palzhj/u4FCPv2/template/u4FCPv2/KUP/sitcp/Projects/README.md

# Project folder

This is temporary folder for project. When working on a project, temporary folders are automatically created to store intermediate and temporary files generated during the various stages of the design process.

**This folder can be cleared when necessary.**
