palzhj/u4FCPv2/template/u4FCPv2/KUP/sitcpxg-fmc1_dp0/scripts/README.md

# Script folder

This is a TCL script folder for vivado.

In Vivado, TCL (Tool Command Language) scripts are used to automate various tasks, perform design operations, and customize the design flow. These scripts are written in the TCL programming language and can be executed within the Vivado environment.
