palzhj/u4FCPv2/template/u4FCPv2/POWER/README.md

# UCD Power Limit

## FMC 12V0

| Spec. Limit | UCD Warning Limit | UCD Software Control Automatic Shutdown Limit | Hardware Shutdown Limit |
| --- | --- | --- | --- |
| 1A  | 2A  | 3A  | 4A  |

## FMC 3V3

| Spec. Limit | UCD Warning Limit | UCD Software Control Automatic Shutdown Limit | Hardware Shutdown Limit |
| --- | --- | --- | --- |
| 3A  | 3A  | 3.5A| 4A  |

## FMC VADJ

| Spec. Limit | UCD Warning Limit | UCD Software Control Automatic Shutdown Limit | Hardware Shutdown Limit |
| --- | --- | --- | --- |
| 4A  | 4A  | 5A  | 6A by DC/DC max output |

## RTM 12V0

| Spec. Limit | UCD Warning Limit | UCD Software Control Automatic Shutdown Limit | Hardware Shutdown Limit |
| --- | --- | --- | --- |
| 3A  | 3.5A| 4.5A| 10.91A |
