palzhj/u4FCPv2/outline/uRTM_dimension.pdf

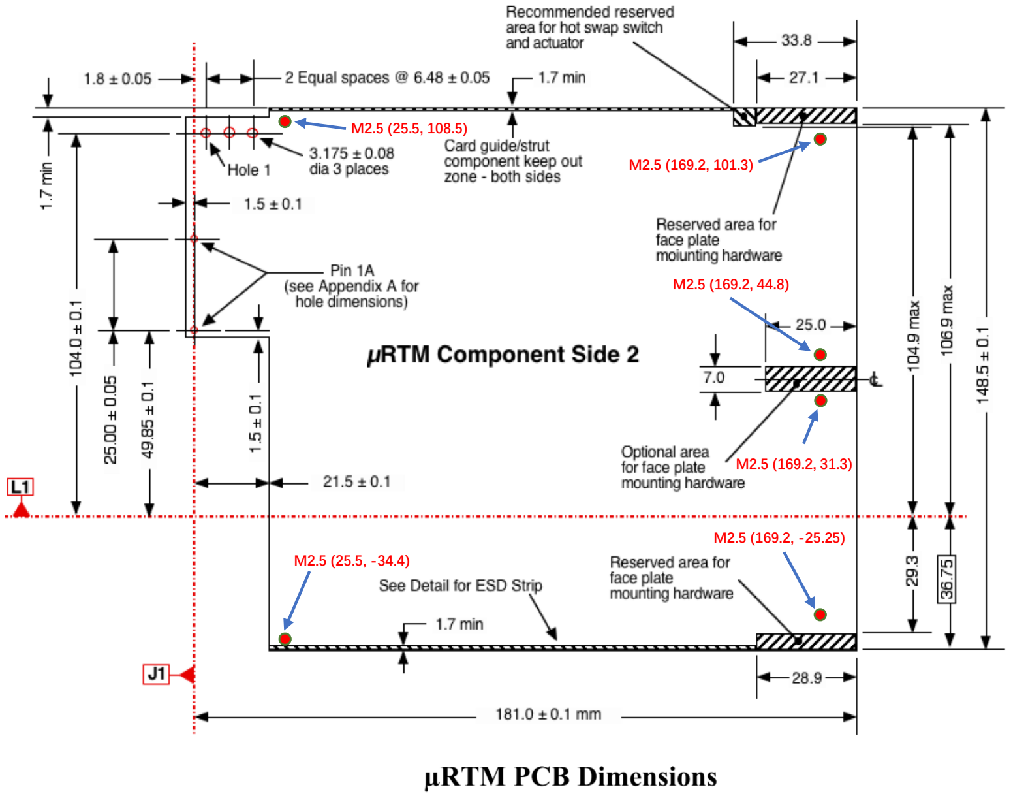
[picture p19: page 1]

M2.5 (169.2, 101.3)

M2.5 (169.2, -25.25)

M2.5 (169.2, 31.3)

M2.5 (169.2, 44.8)

M2.5 (25.5, 108.5)

M2.5 (25.5, -34.4)
