palzhj/u4FCPv2/template/u4FCPv2/KUP/sitcp/sources/wishbone/wb_reg/reg_table.xlsx

block name | reg_table
byte size | 256
bus width | 8
protocol | wishbone
name | offset addres | size | type | name | assignment | type | initial value | reference | labels | comment
syn_info |  |  |  | hour | 8 | rof | default: 0x0 |  |  | Synthesis date - hour, BCD (00-23)
 |  |  |  | date | 8 | rof | default: 0x0 |  |  | Synthesis date - day of month, BCD (01-31)
 |  |  |  | month | 8 | rof | default: 0x0 |  |  | Synthesis date - month, BCD (01-12)
 |  |  |  | year | 8 | rof | default: 0x0 |  |  | Synthesis date - two-digit year, BCD (00-99); century implied
syn_ver |  |  |  |  | 8 | rof | default: 0x0 |  |  | Firmware version (auto update at synthesis)
sys_rst |  |  |  | usr_rst | 1 | w1trg | default: 0x0 |  |  | Write 1 to generate a reset pulse for the user logic; write 0 has no effect
 |  |  |  | ddr_rst | 1 | w1trg | default: 0x0 |  |  | Write 1 to generate a reset pulse for the DDR; write 0 has no effect
mod_rst |  |  |  | mod_rst | 1 | w1trg | default: 0x0 |  |  | Write 1 to generate a reset pulse for the front-end modules; write 0 has no effect
 |  |  |  | qsfp_rst | 1 | w1trg | default: 0x0 |  |  | Write 1 to generate a reset pulse for the QSFP; write 0 has no effect
sys_sta |  |  |  | clk_lock | 1 | ro | default: 0x0 |  |  | 0 = MMCM not locked; 1 = MMCM locked
sys_sta_lch |  |  |  | clk_lock | 1 | rotrg | default: 0x0 |  |  | Latched copy of sys_sta.clk_lock. Sticky: cleared by reading this register
mod_sta |  |  |  | temp_alm | 1 | ro | default: 0x0 |  |  | 0 = Normal; 1 = Over-temperature alarm
 |  |  |  | lv_alm | 1 | ro | default: 0x0 |  |  | 0 = Normal; 1 = Low-voltage over-current alarm
 |  |  |  | hv_alm | 1 | ro | default: 0x0 |  |  | 0 = Normal; 1 = High-voltage over-current alarm
 |  |  |  | qsfp_alm | 1 | ro | default: 0x0 |  |  | 0 = Normal; 1 = QSFP28 alarm (module fault or critical host status)
 |  |  |  | qsfp_prs | 1 | ro | default: 0x0 |  |  | 0 = QSFP module absent; 1 = QSFP module present
mod_sta_lch |  |  |  | temp_alm | 1 | rotrg | default: 0x0 |  |  | Latched copy of mod_sta.temp_alm. Sticky: cleared by reading this register
 |  |  |  | lv_alm | 1 | rotrg | default: 0x0 |  |  | Latched copy of mod_sta.lv_alm. Sticky: cleared by reading this register
 |  |  |  | hv_alm | 1 | rotrg | default: 0x0 |  |  | Latched copy of mod_sta.hv_alm. Sticky: cleared by reading this register
 |  |  |  | qsfp_alm | 1 | rotrg | default: 0x0 |  |  | Latched copy of mod_sta.qsfp_alm. Sticky: cleared by reading this register
 |  |  |  | qsfp_prs | 1 | rotrg | default: 0x0 |  |  | Latched copy of mod_sta.qsfp_prs. Sticky: cleared by reading this register
clk |  |  |  | ext_en | 1 | rw | default: 0x0 |  |  | 0 = Use on-board/local clock; 1 = Use external clock from AMC
lv |  |  |  | enable | 1 | rw | default: 0x0 |  |  | 0 = Module power OFF; 1 = Module power ON
 |  |  |  | ot_auto_off | 1 | rw | default: 0x0 |  |  | 0 = Normal; 1 = Auto power OFF on over-temperature
hv |  |  |  | stop | 1 | rw | default: 0x1 |  |  | 0 = High voltage ON; 1 = High-voltage emergency shutdown (safe default: 1)
 |  |  |  | oc_auto_off | 1 | rw | default: 0x0 |  |  | 0 = Normal; 1 = Auto power OFF on over-current
qsfp |  |  |  | lpmode | 1 | rw | default: 0x0 |  |  | 0 = Normal (Full-Power) mode; 1 = Low-Power mode
