palzhj/u4FCPv2/template/u4FCPv2/KUP/sitcpxg-fmc1_dp0/sources/wishbone/wb_reg/reg_table.xlsx

block name | reg_table
byte size | 256
name | offset addres | size | type | name | assignment | type | initial value | reference | labels | comment
syn_info |  |  |  | hour | 8 | rof | default: 0x0 |  |  | Synthesis date: Hour, binary-coded decimal expression
 |  |  |  | date | 8 | rof | default: 0x0 |  |  | Synthesis date: Date
 |  |  |  | month | 8 | rof | default: 0x0 |  |  | Synthesis date: Month
 |  |  |  | year | 8 | rof | default: 0x0 |  |  | Synthesis date: Last two figures of A.D.
syn_ver |  |  |  |  | 8 | rof | default: 0x0 |  |  | Firmware Version
fpga_dna |  |  |  |  | 64 | ro |  |  |  | FPGA DNA ID
tcp_mode |  |  |  |  | 2 | rw | default: 0x0 |  |  | TCP mode: 2’b01 - Loopback mode, 2’b10 - Test mode, 2’b00 – Normal mode
tcp_test_tx_rate |  |  |  |  | 8 | rw | default: 0x1 |  |  | Transmission data rate in units of 100 Mbps for TCP test mode
tcp_test_num_of_data |  |  |  |  | 64 | rw | default: 0x4000 |  |  | Number of bytes to be transmitted for TCP test mode
tcp_test_data_gen |  |  |  |  | 1 | rw | default: 0x0 |  |  | Data transmission enable for TCP test mode
tcp_test_word_len |  |  |  |  | 3 | rw | default: 0x7 |  |  | Word length of test data for one clock cycle for TCP test mode
tcp_test_select_seq |  |  |  |  | 1 | rw | default: 0x0 |  |  | Use the sequence pattern as defined below for TCP test mode
tcp_test_seq_pattern |  |  |  |  | 32 | rw | default: 0x60808040 |  |  | Sequence pattern, each 4-bit define the number of bytes for one clock cycle
tcp_test_blk_size |  |  |  |  | 24 | rw | default: 0x400 |  |  | Transmission block size in bytes for TCP test mode
tcp_test_ins_error |  |  |  |  | 1 | w1trg | default: 0x0 |  |  | Data error insertion for TCP test mode
