palzhj/u4FCPv2/outline/URTM_V2_3D_bare_pcb.stp

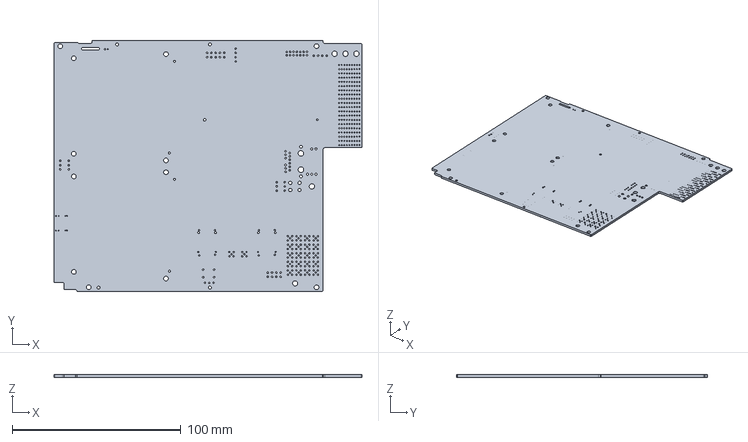
[picture p20: CAD file, 2025-03-28]
outline/URTM_V2_3D_bare_pcb.stp
182.5 x 148.5 x 1.58 mm
