palzhj/u4FCPv2/outline/U4FCP_V2_bare_pcb.stp

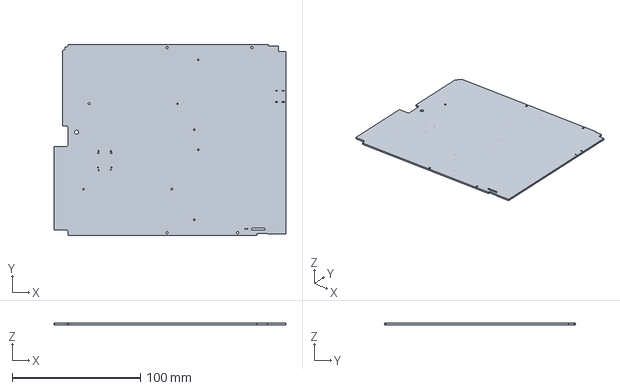
[picture p21: CAD file, 2025-03-26]
outline/U4FCP_V2_bare_pcb.stp
180.6 x 148.5 x 1.43 mm
