palzhj/u4FCPv2/template/uRTMv2/K7/URTM_V2_3r.pdf

# RTM

# ReDri

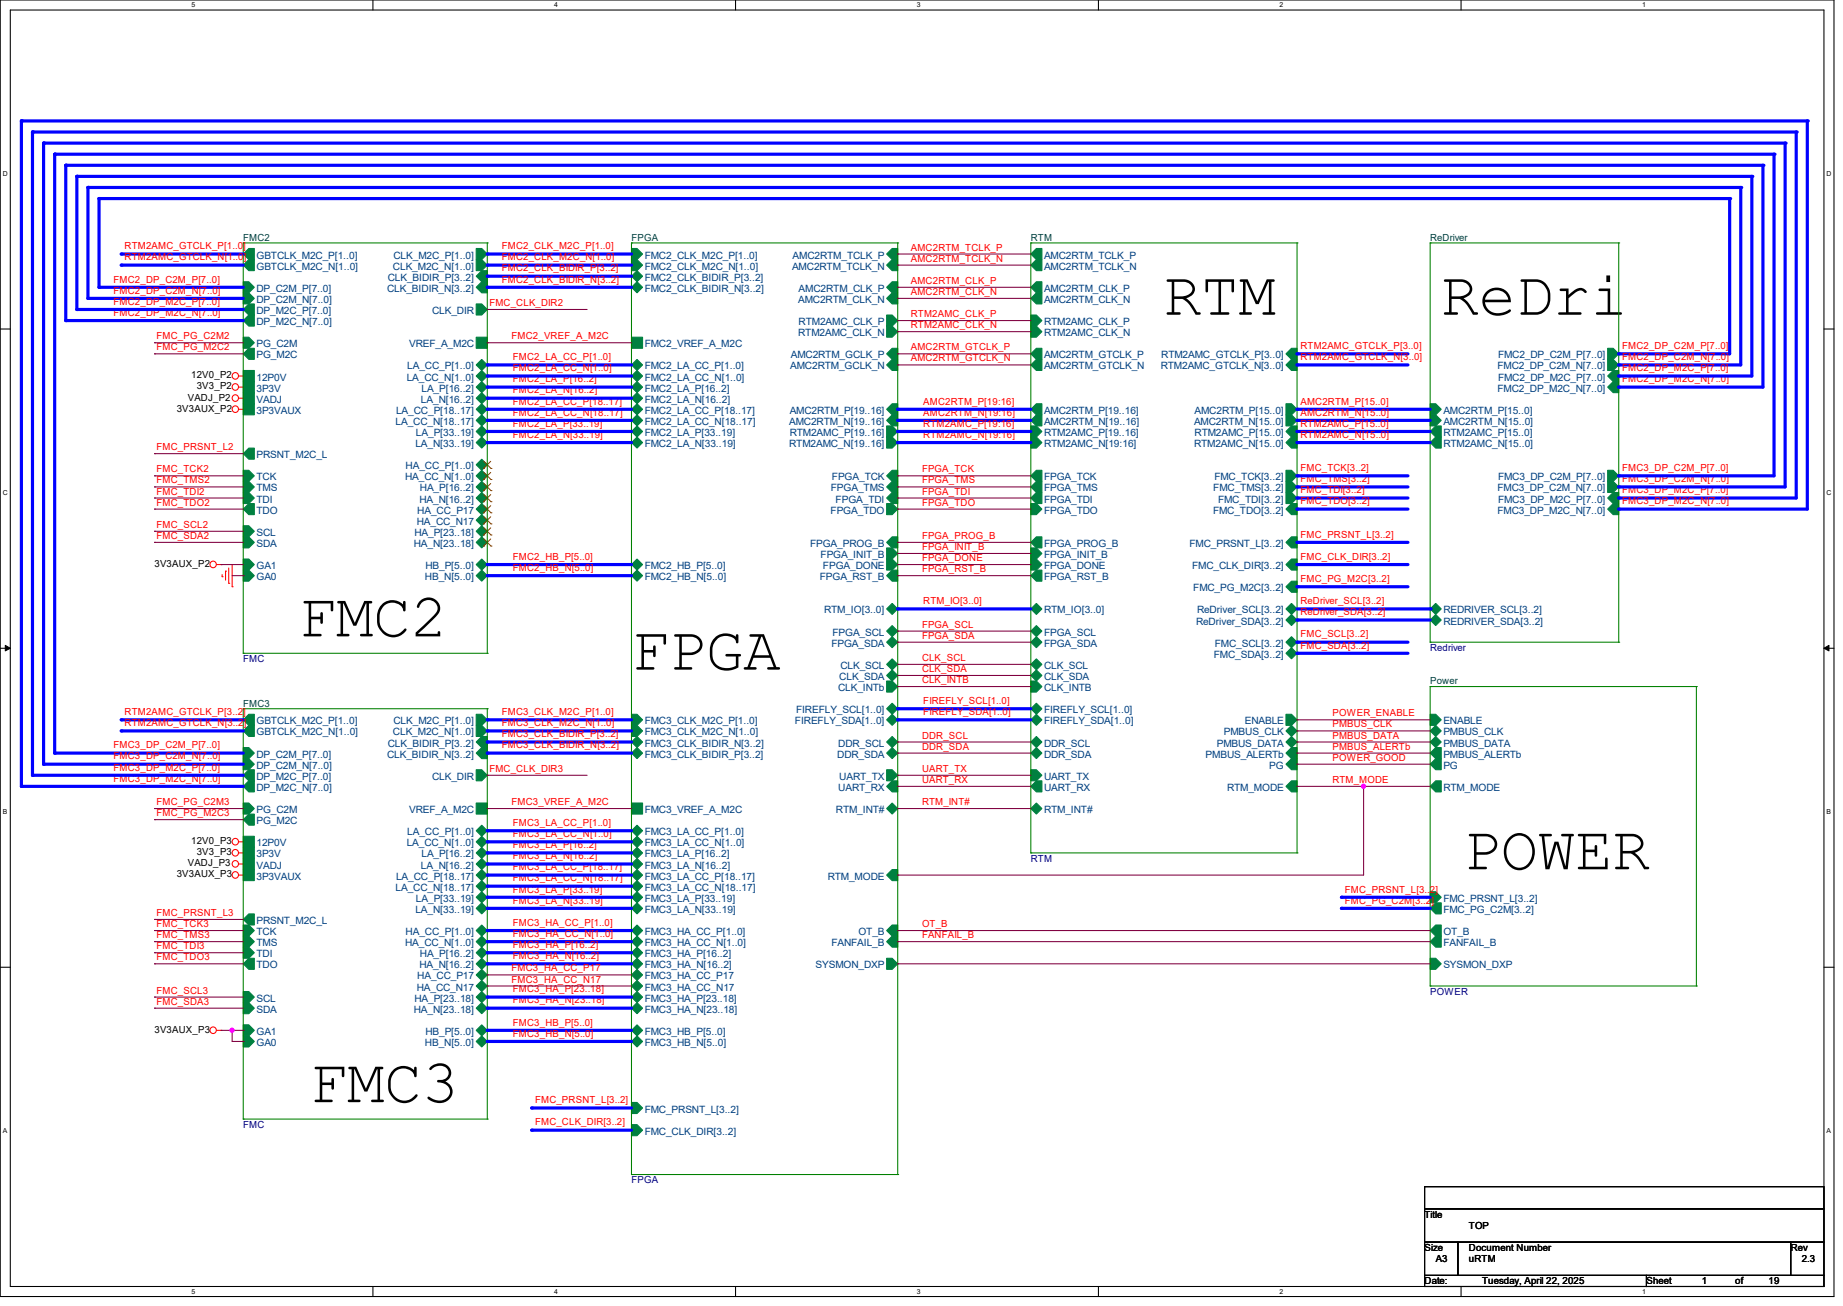
[picture p22: page 1]
FPGA; FMC3; FMC2; POWER; 3V3AUX_P3; 3V3AUX_P3 VADJ_P3; 3V3AUX_P2; 3V3AUX_P2 VADJ_P2; Title Size; Document Number; Rev Date:; Sheet; of uRTM; 2.3 TOP; Tuesday, April 22, 2025; 19 Title Size; FMC3_LA_CC_N[18..17] FMC3_LA_N[33..19] FMC3_LA_P[33..19] FMC3_LA_CC_P[18..17]; FPGA_SCL FPGA_SDA; FMC3_VREF_A_M2C; FMC3_LA_CC_N[1..0] FMC3_LA_CC_P[1..0] FMC3_LA_P[16..2] FMC3_LA_N[16..2]; FPGA_DONE; FPGA_PROG_B; FPGA_TDI FPGA_INIT_B; FPGA_TMS; FPGA_TCK; FPGA_RST_B; FPGA_TDO; SYSMON_DXP; CLK_SCL CLK_SDA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

# FMC2_CLK_OUT_P2 FMC2_CLK_OUT_N2 FMC3_CLK_OUT_P2 FMC3_CLK_OUT_N2 FPGA_CLK_SW_P

# IN2 15 SCLK 16 A1/SDO 17 SDA/SDIO 18

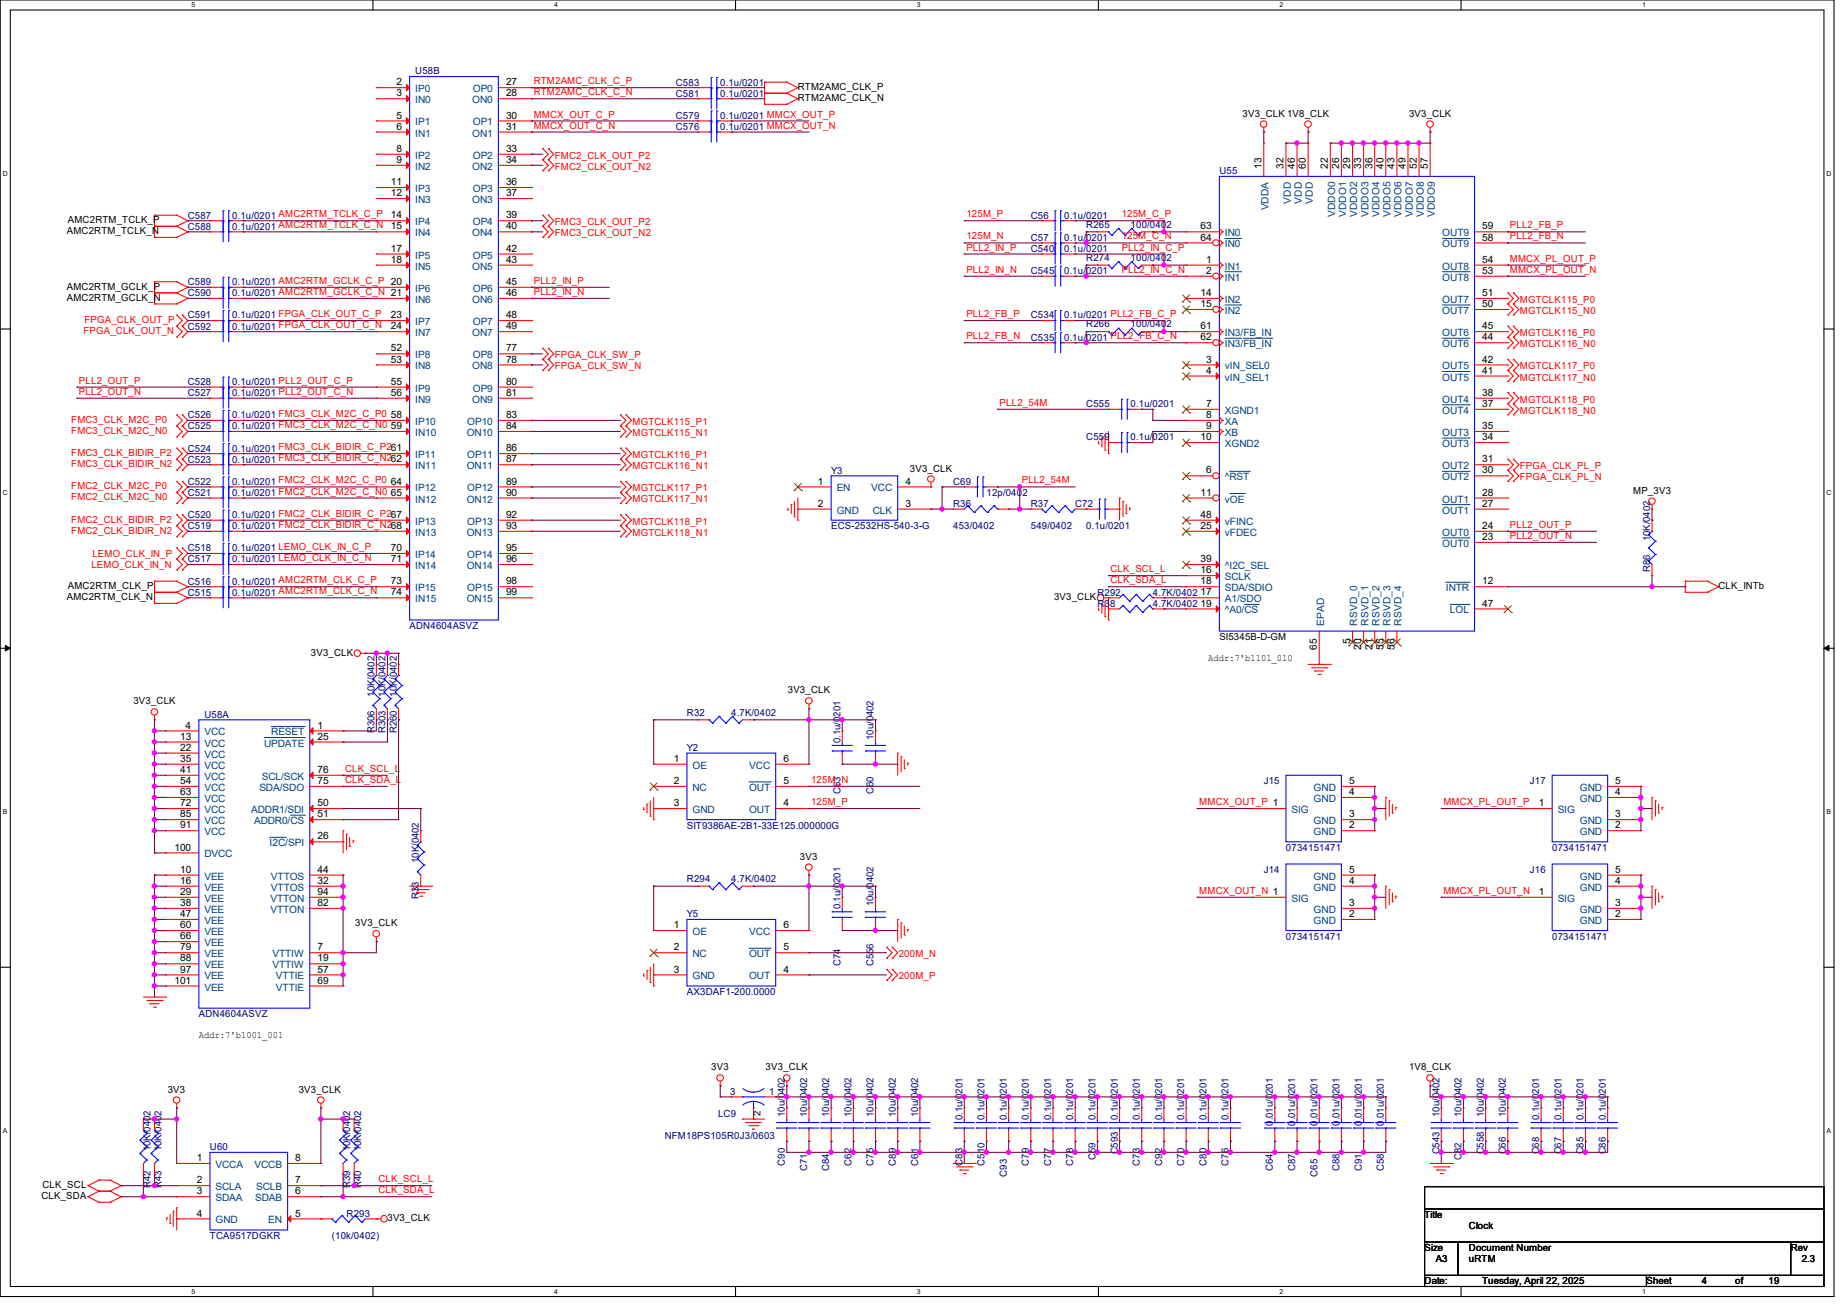
[picture p23: page 2]

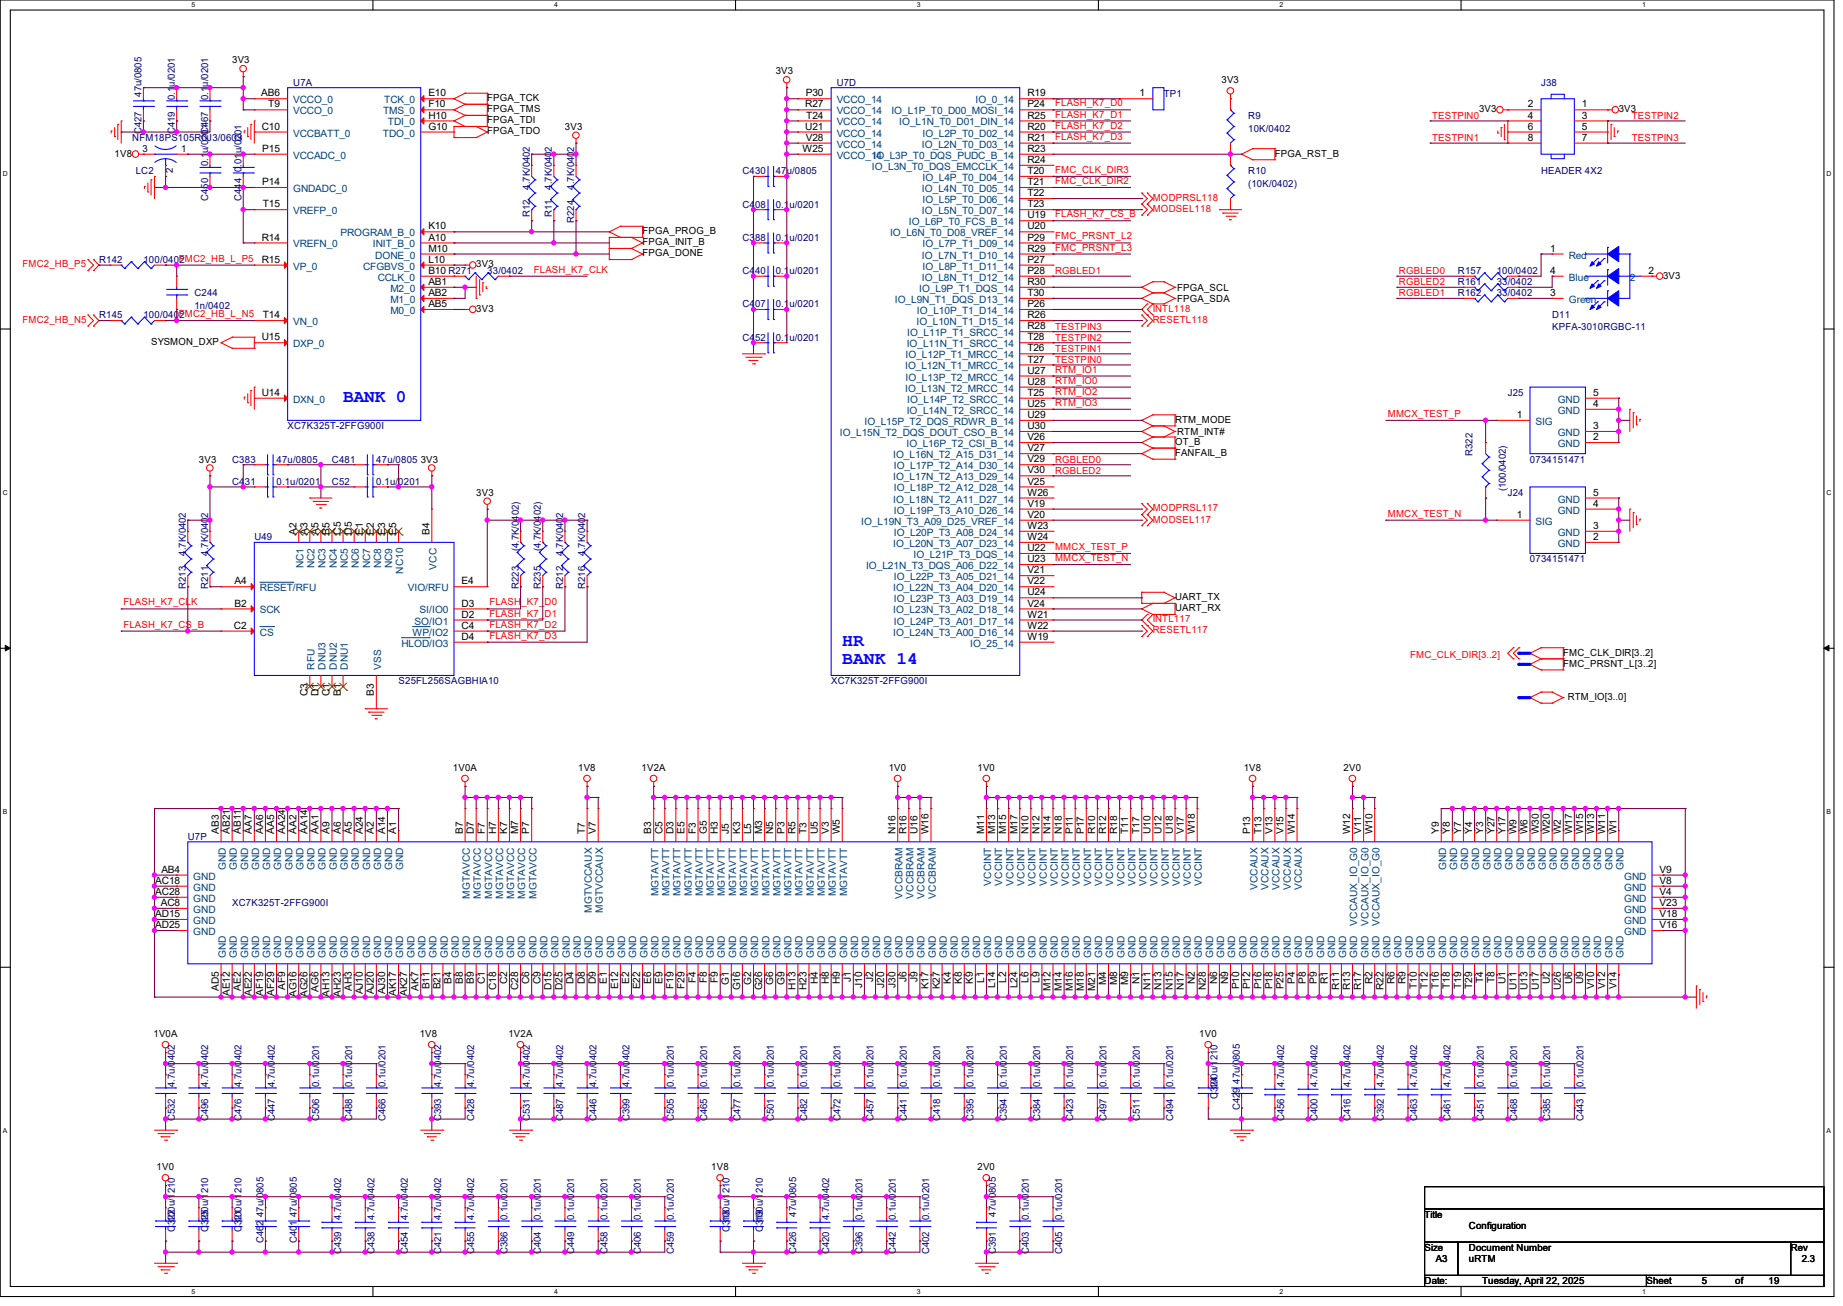
[picture p24: page 3]

# 1V35 VTTVREF

C379 | 0.1u/0201 C320 | 100u/1210 C²³⁹⁰.1u/0201 | R199

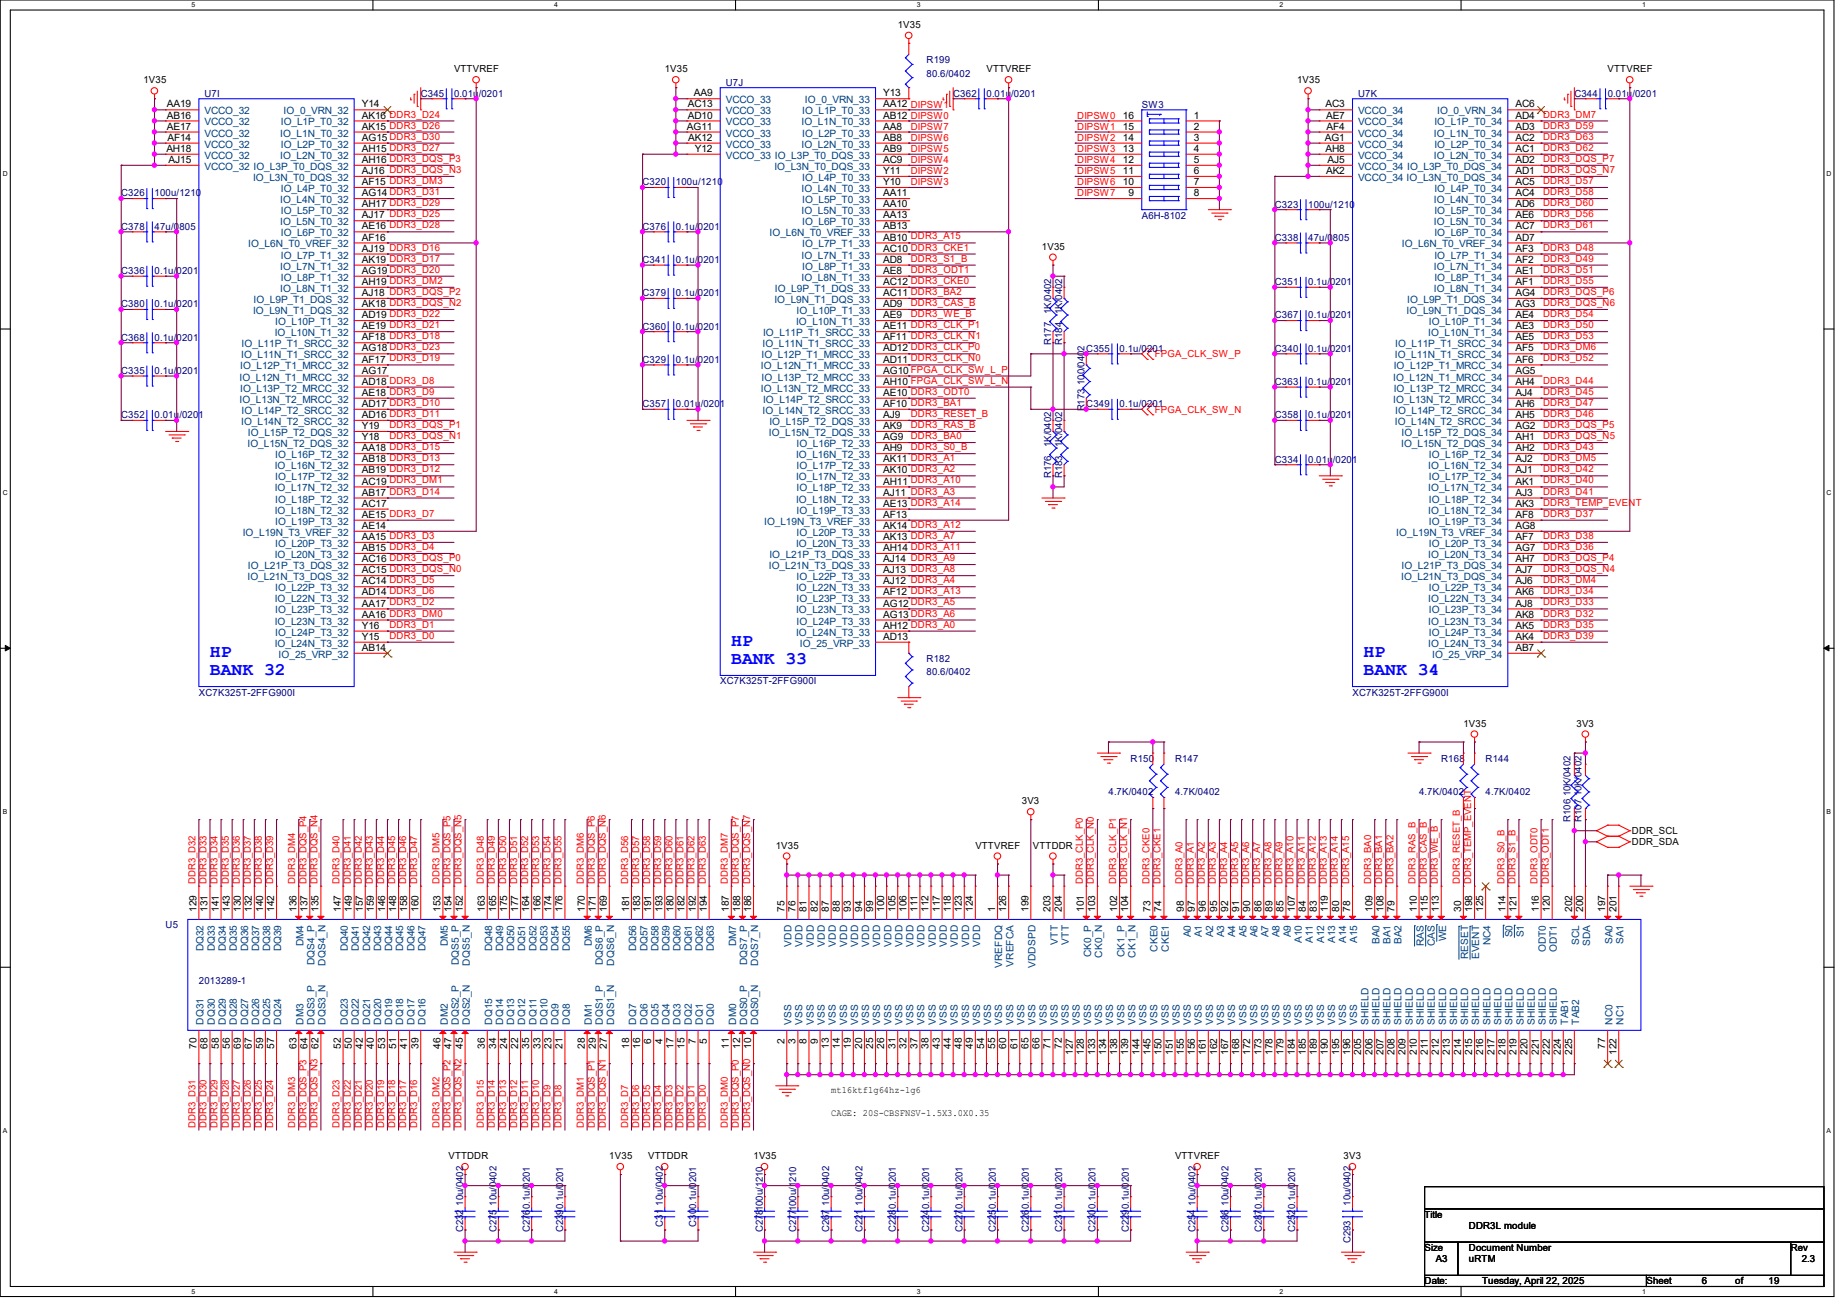
[picture p25: page 4]

6 DQ6 16 DQ7 18 DQ8 21 DQ9 23 DQ10 33 DQ11 35 DQ12 22 DQ13 24 DQ14 34 DQ15 36 DQ16 39 DQ17 41 DQ18 51 DQ19 53 DQ20 40 DQ21 42 DQ22 50 DQ23 52 DQ24 57 DQ25 59 DQ26 67 DQ27 69 DQ28 56 DQ29 58 DQ30 68 DQ31 70 DQ32 129 DQ33 131 DQ34 141 DQ35 143 DQ36 130 DQ37 132 DQ38 140 DQ39 142 DQ40 147 DQ41 149 DQ42 157 DQ43 159 DQ44 146 DQ45 148 DQ46 158 DQ47 160 DQ48 163 DQ49 165 DQ50 175 DQ51 177 DQ52 164 DQ53 166 DQ54 174 DQ55 176 DQ56 181 DQ57 183 DQ58 191 DQ59 193 DQ60 180 DQ61 182 DQ62 192 DQ63 194 DQS0_N 10 DQS0_P 12 DQS1_N 27 DQS1_P 29 DQS2_N 45 DQS2_P 47 DQS3_N 62 DQS3_P 64 DQS4_N 135 DQS4_P 137 DQS5_N 152 DQS5_P 154 DQS6_N 169 DQS6_P 171 DQS7_N 186 DQS7_P 188 NC0 77 A15 78 A14 80 NC1 122 NC4 125 ODT0 116 ODT1 120 SA0 197 SA1 201 SCL 202 SDA 200 VDD 75 VDD 76 VDD 81 VDD 82 VDD 87 VDD 88 VDD 93 VDD 94 VDD 99 VDD 100 VDD 105 VDD 106 VDD 111 VDD 112 VDD 117 VDD 118 VDD 123 VDD 124 VDDSPD 199 VREFCA 126 VREFDQ

9 VSS 13 VSS 14 VSS 19 VSS 20 VSS 25 VSS 26 VSS 31 VSS 32 VSS 37 VSS 38 VSS 43 VSS 44 VSS 48 VSS 49 VSS 54 VSS 55 VSS 60 VSS 61 VSS 65 VSS 66 VSS 71 VSS 72 VSS 127 VSS 128 VSS 133 VSS 134 VSS 138 VSS 139 VSS 144 VSS 145 VSS 150 VSS 151 VSS 155 VSS 156 VSS 161 VSS 162 VSS 167 VSS 168 VSS 172 VSS 173 VSS 178 VSS 179 VSS 184 VSS 185 VSS 189 VSS 190 VSS 195 VSS 196 SHIELD 205 SHIELD 206 SHIELD 207 SHIELD 208 SHIELD 209 SHIELD 210 SHIELD 211 SHIELD 212 SHIELD 213 SHIELD 214 SHIELD 215 SHIELD 216 SHIELD 217 SHIELD 218 SHIELD 219 SHIELD 220 SHIELD 221 SHIELD 222 TAB1 224 TAB2 225

0734151471 SIG 1 | GND 2 GND 3 GND 4 GND 5 | R²⁸⁷ ¹⁰K/0402
0734151471 SIG 1 | GND 2 GND 3 GND 4 GND 5 R²⁸⁴ ¹⁰K/0402

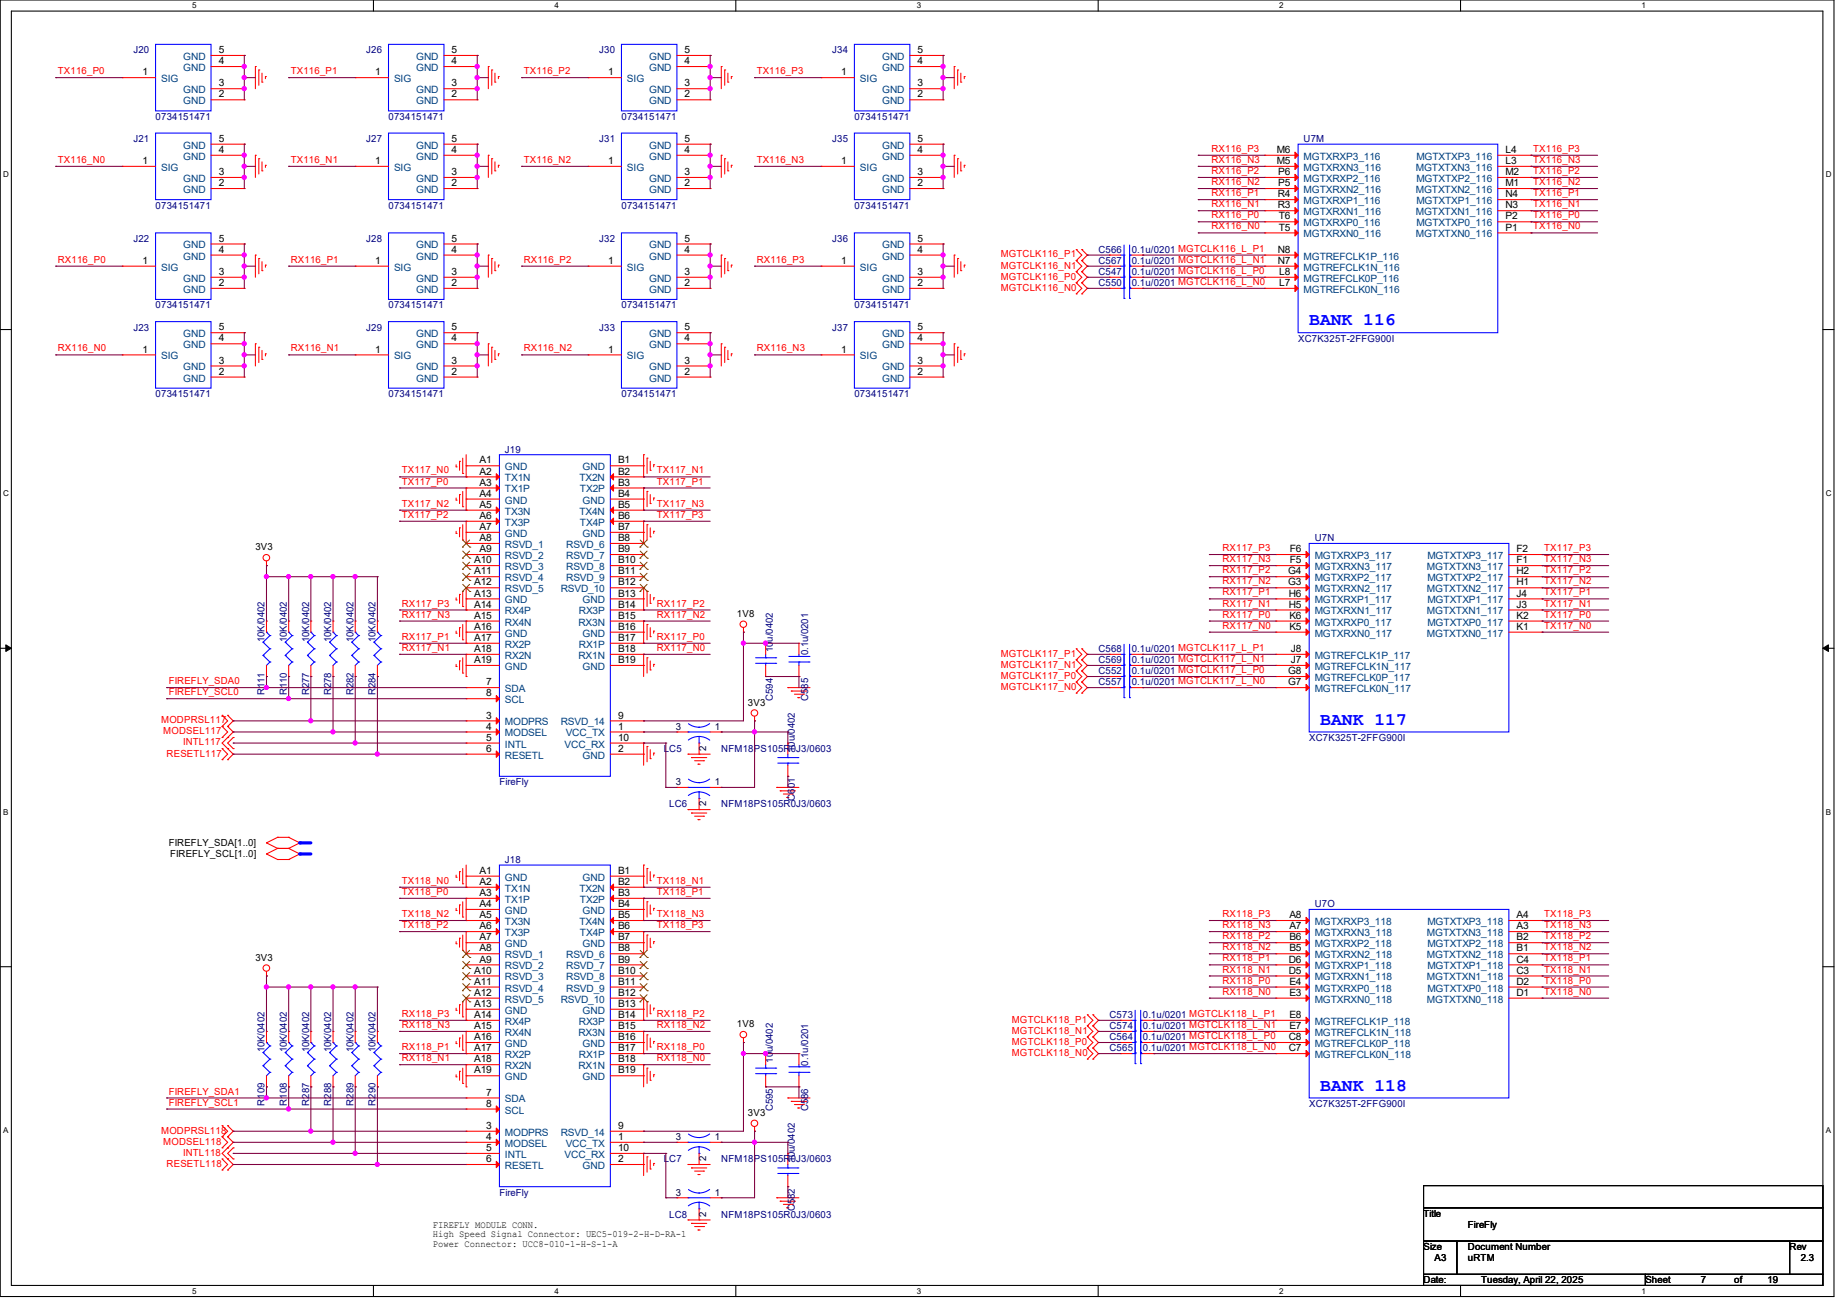
[picture p26: page 5]

High Speed Signal Connector: UEC5-019-2-H-D-RA-1
Power Connector: UCC8-010-1-H-S-1-A

FMC2_LA_P3 FMC2_LA_N3 FMC2_LA_P15 FMC2_LA_N15 FMC2_LA_P12 FMC2_LA_N12 FMC2_LA_P14 FMC2_LA_N14 FMC2_LA_P16 FMC2_LA_N16 FMC2_LA_CC_P1 FMC2_LA_CC_N1 FMC2_LA_P2 FMC2_LA_N2 FMC2_LA_N4 FMC2_LA_P4 FMC2_LA_P6 FMC2_LA_N6 FMC2_LA_P30 FMC2_LA_N30 FMC2_LA_P31 FMC2_LA_N31 FMC2_LA_P28 FMC2_LA_N28 FMC2_LA_CC_P18 FMC2_LA_CC_N18 FMC2_LA_P27 FMC2_LA_N27 FMC2_LA_P25 FMC2_LA_N25 FMC2_LA_P20 FMC2_LA_N20 FMC2_LA_P23 FMC2_LA_N23

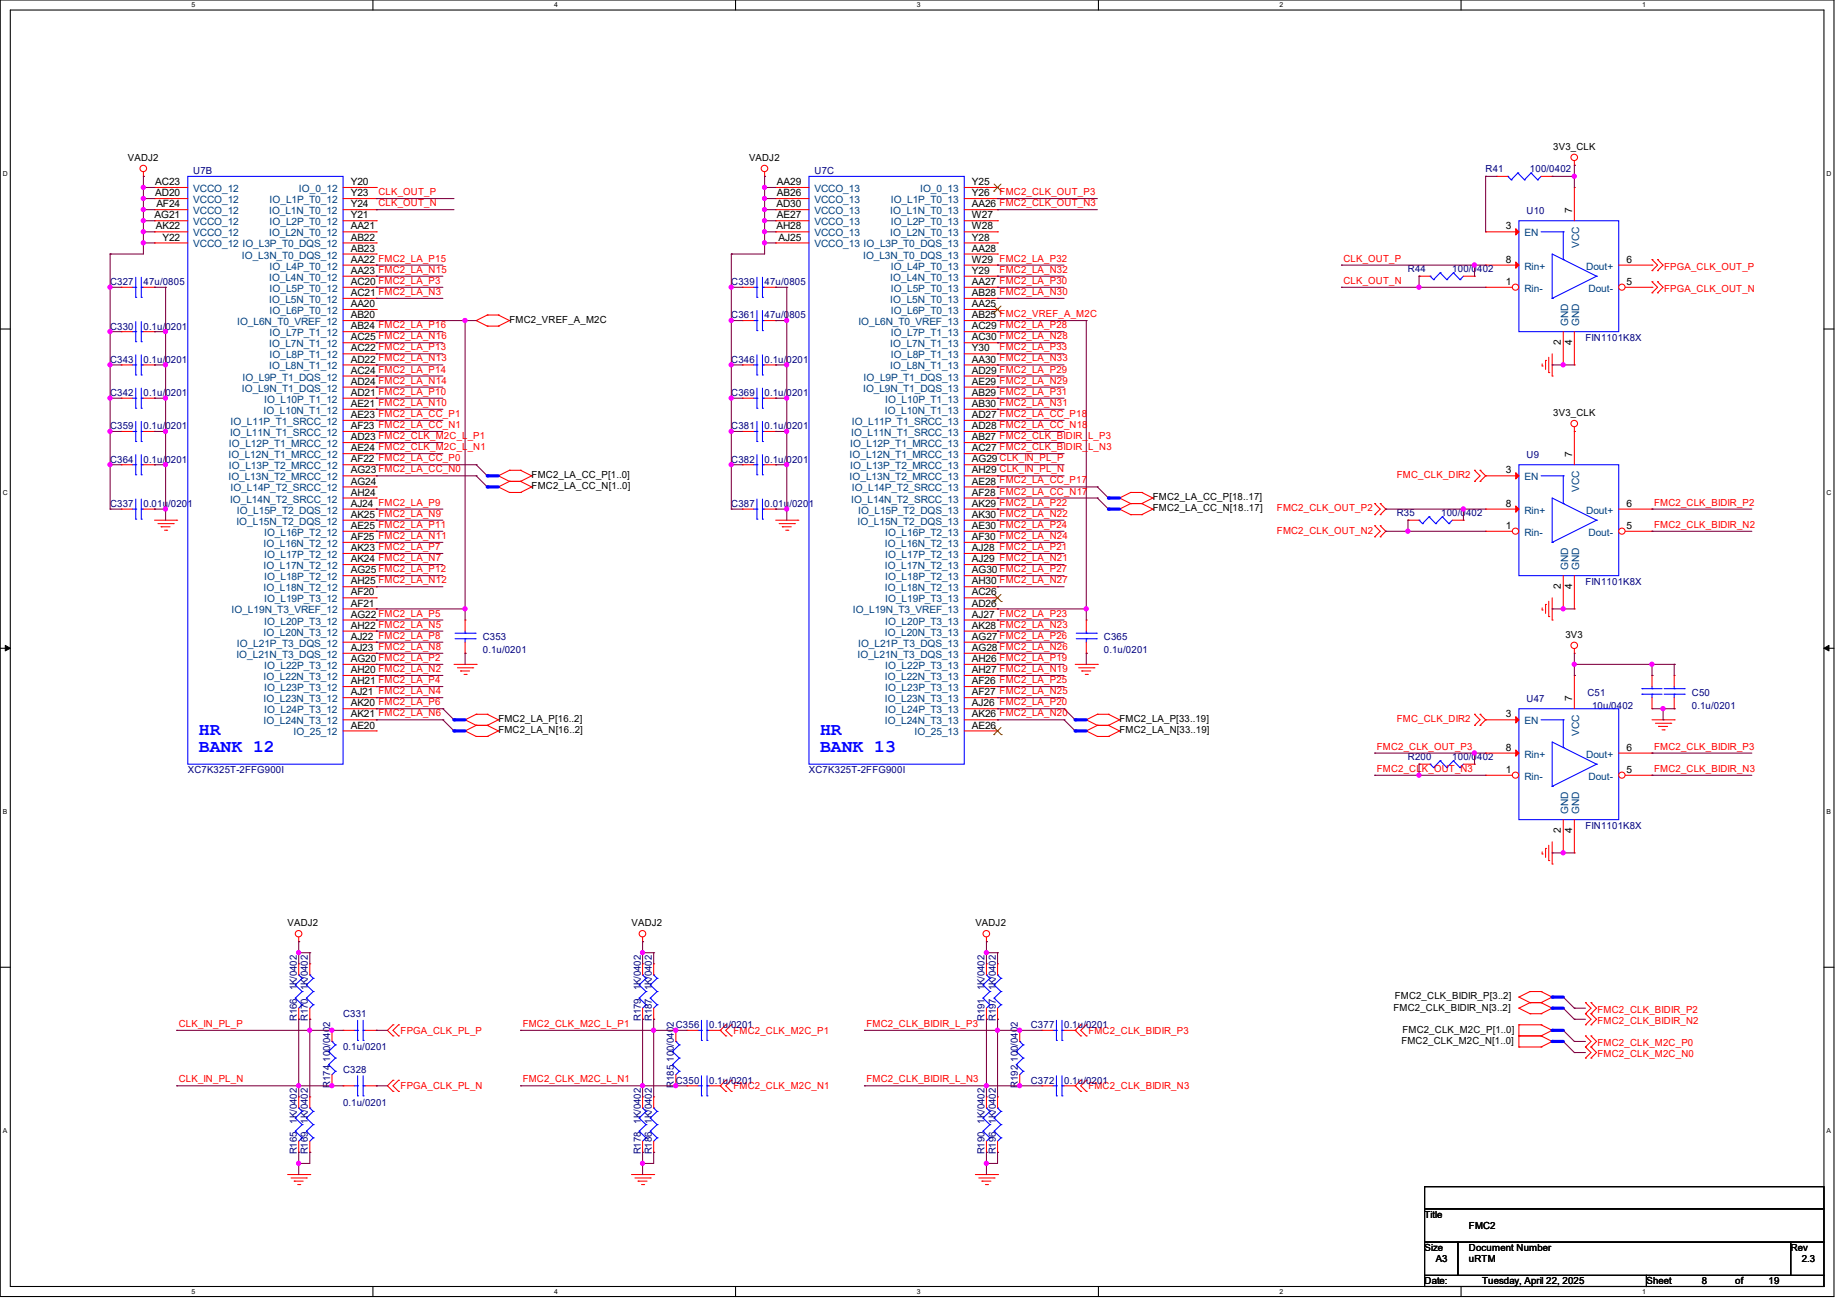
[picture p27: page 6]

FMC3_LA_CC_N1 FMC3_LA_CC_P1 FMC3_LA_N10 FMC3_LA_P10 FMC3_LA_N14 FMC3_LA_P14 FMC3_LA_N13 FMC3_LA_P13 FMC3_LA_N16 FMC3_LA_P16 FMC3_LA_N6 FMC3_LA_P6 FMC3_LA_N5 FMC3_LA_P5 FMC3_LA_N8 FMC3_LA_P8 FMC3_LA_N12 FMC3_LA_P12
FMC3_LA_N11 FMC3_LA_P11 FMC3_LA_N9 FMC3_LA_P9 FMC3_LA_N4 FMC3_LA_P4 FMC3_LA_N3 FMC3_LA_P3 FMC3_LA_N2 FMC3_LA_P2

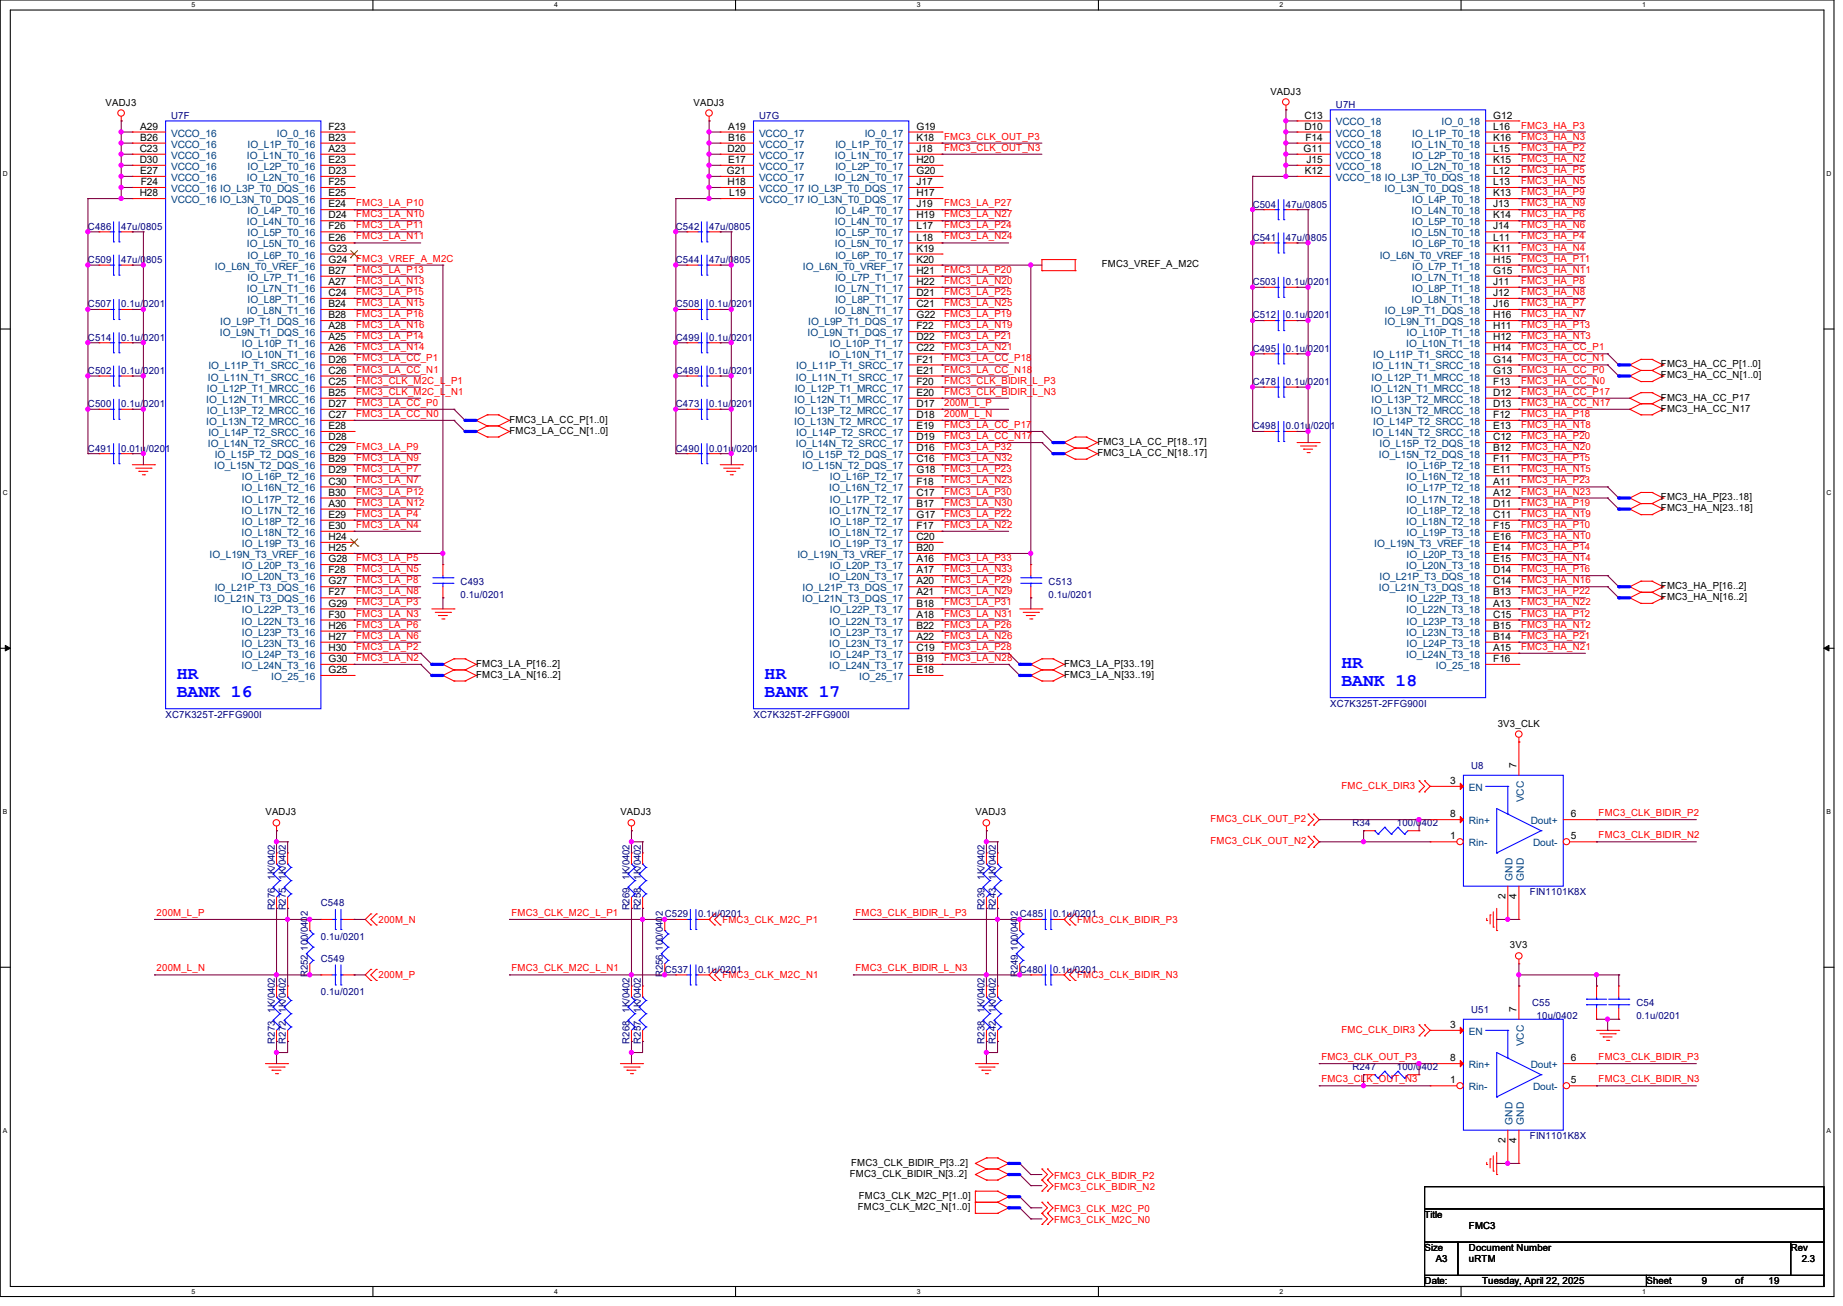
[picture p28: page 7]

VDDIO 19 VDDIO 30 VDDIO 41 VDDA1P8 13 VDDA1P8 48 VDDA2P5 3 VDDA2P5 9 VDD1P0 6 VDD1P0 24 VDD1P0 31 VDD1P0 42 GTX_CLK 29 TX_CTRL/EN 37 TX_D0/SGMII_SIN 28 TX_D1/SGMII_SIP 27 TX_D2 26 TX_D3 25 RX_CTRL/DV 38 GPIO0/RX_ER 39 RX_CLK 32 RX_D0/SGMII_COP 33 RX_D1/SGMII_CON 34 RX_D2/SGMII_SOP 35 RX_D3/SGMII_SON 36 GPIO1/COL 40 RBIAS 12

# TD_P_A 1 TD_M_A 2 TD_M_B 5 TD_P_B 4 TD_M_C 8 TD_P_C 7 TD_P_D 10 TD_M_D 11

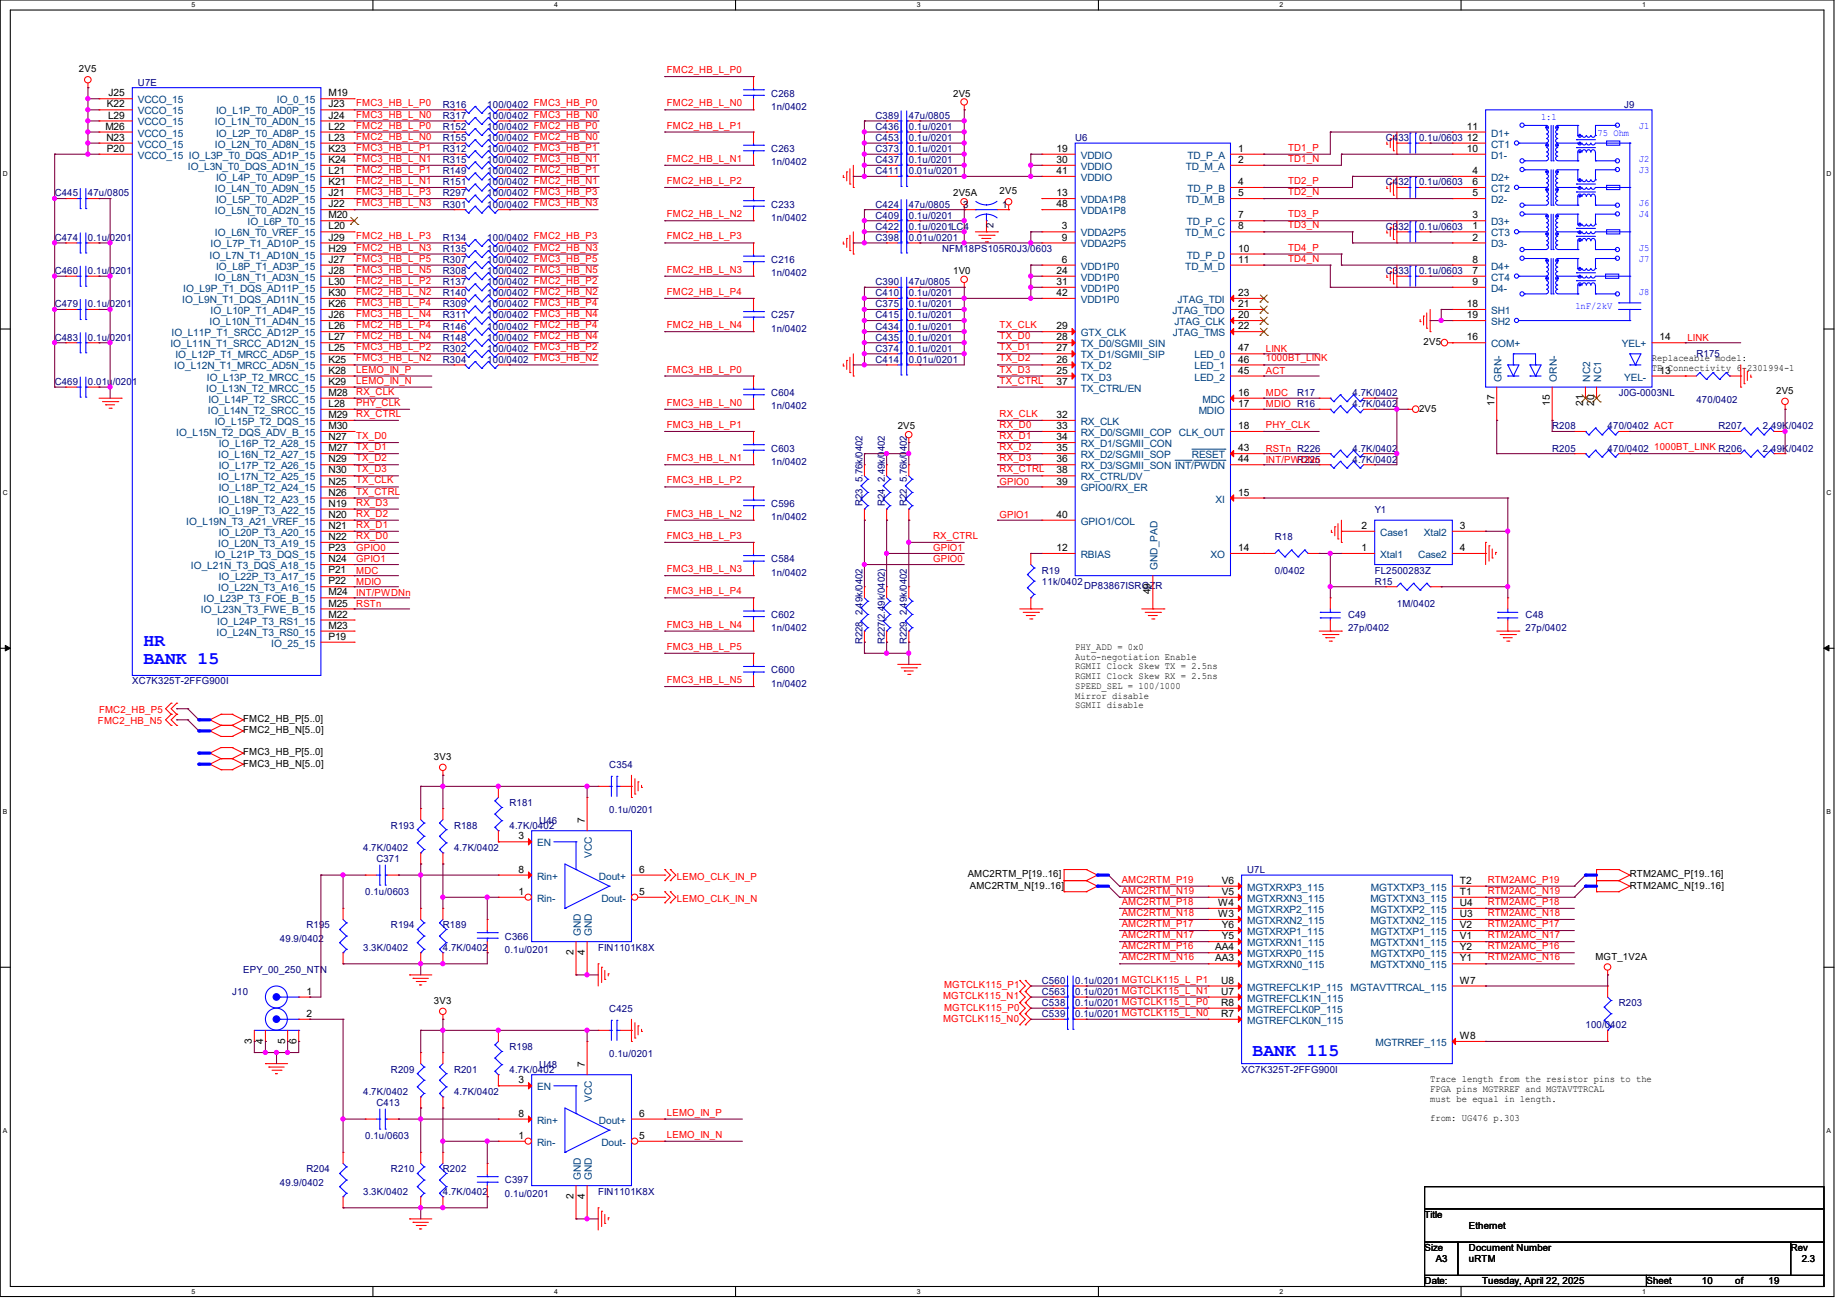
[picture p29: page 8]

INT/PWDNn RSTn MDIO MDC GPIO0 GPIO1 TX_CLK

INT/PWDN 44 XI 15 XO 14 GND_PAD 49

PHY_ADD = 0x0
Auto-negotiation Enable
RGMII Clock Skew TX = 2.5ns
RGMII Clock Skew RX = 2.5ns
SPEED_SEL = 100/1000
Mirror disable
SGMII disable

A A Trace length from the resistor pins to the

FPGA pins MGTRREF and MGTAVTTRCAL
must be equal in length.
from: UG476 p.303

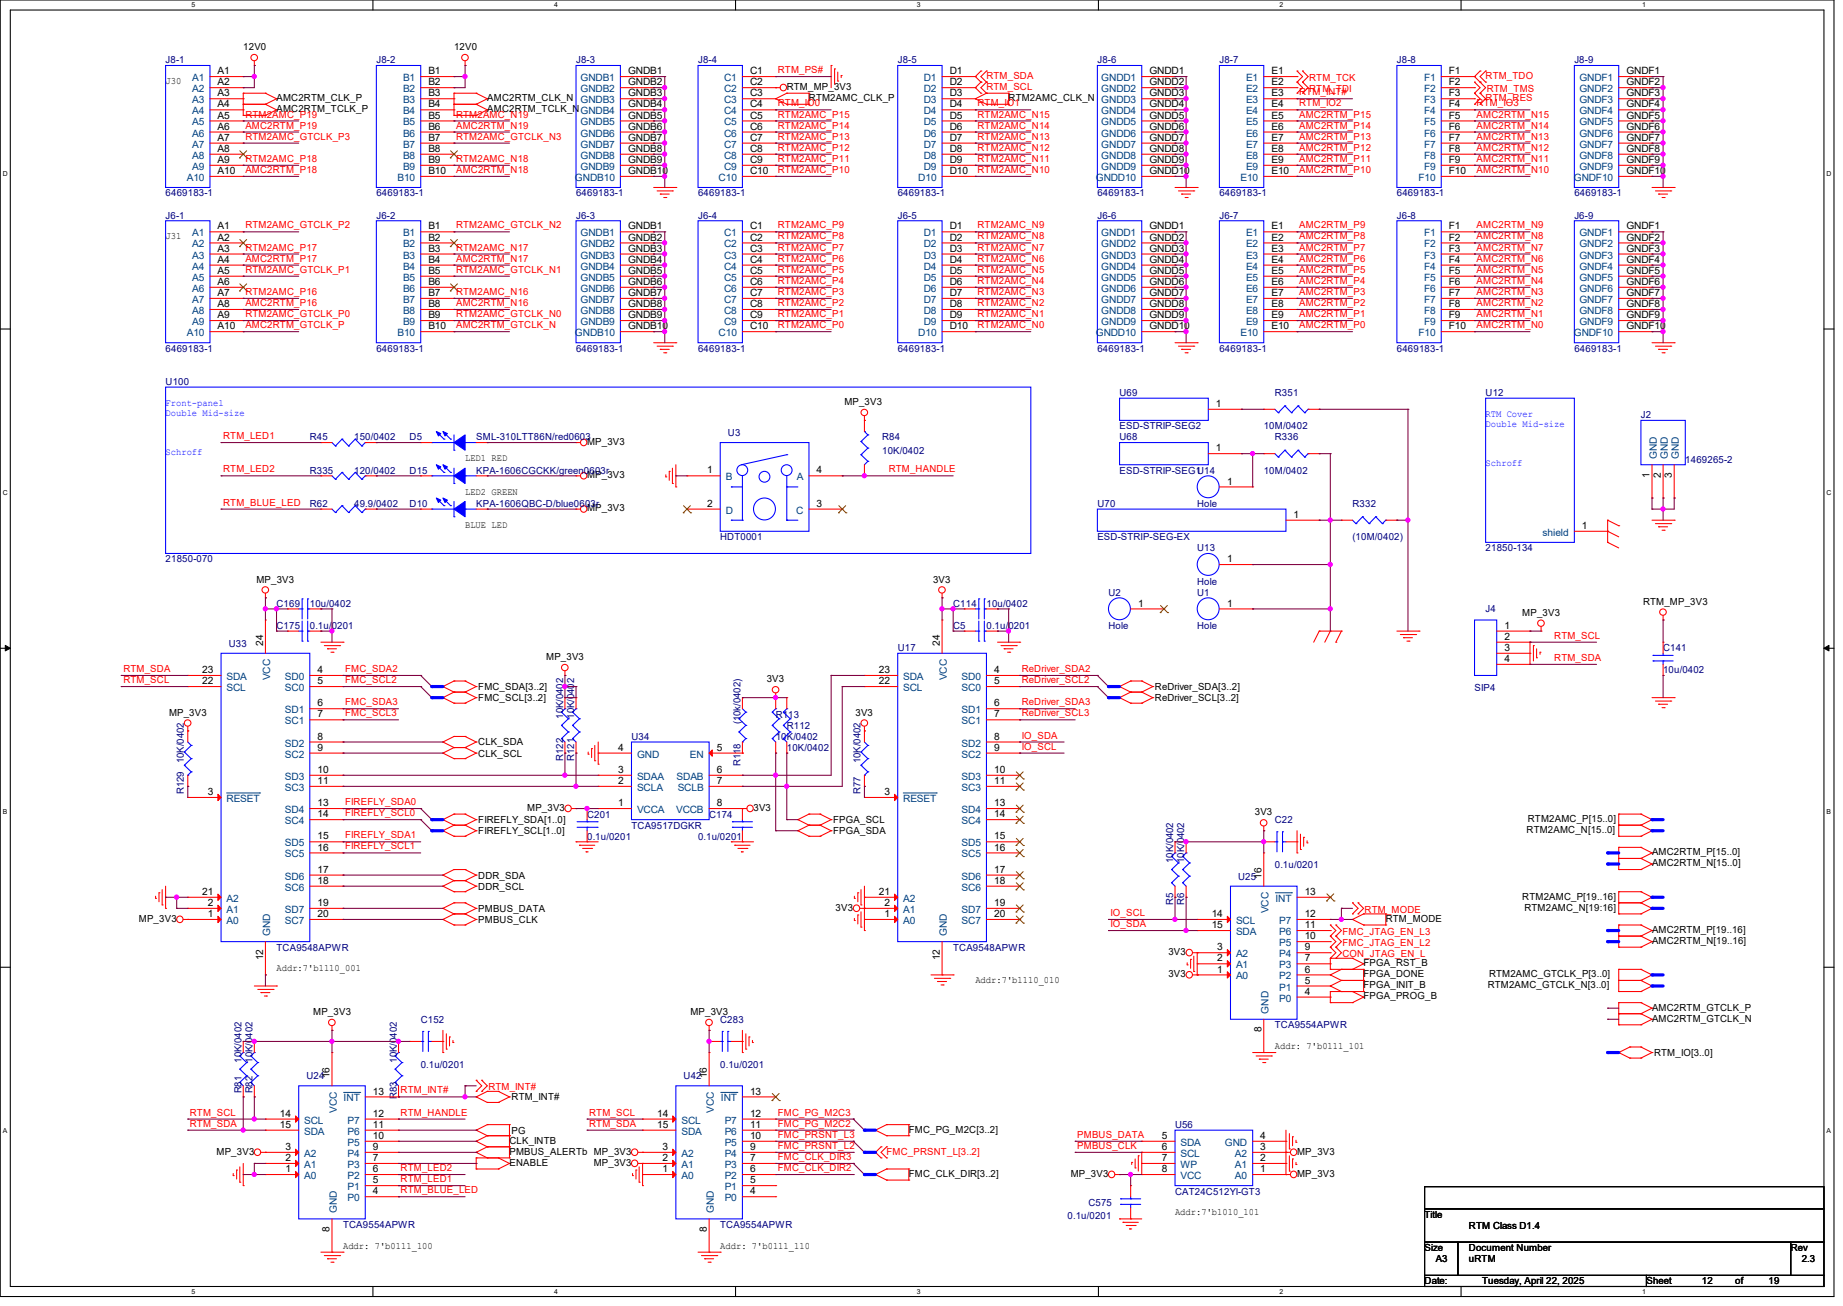
[picture p30: page 9]

U70 ESD-STRIP-SEG-EX

U56 CAT24C512YI-GT3 A0 1 A1 2 A2 3 GND 4 SDA 5 SCL 6 WP 7 VCC 8

C116 | 220n/0201 C13
U30 A0RXP 2 A0RXN 3 A1RXP 5 A1RXN 6 A2RXP 8 A2RXN 9 A3RXP 11 A3RXN 12 | B0TXP 48 B0TXN 47 B1TXP 45 B1TXN 44 B2TXP 42 B2TXN 41 B3TXP 39 B3TXN 38 VCC 4 VCC 7 VCC 10 VCC 17 VCC 20 VCC 23 VCC 33 VCC 40 VCC 43 VCC 46 VCC 50 VCC 53 VCC 56 VCC 59

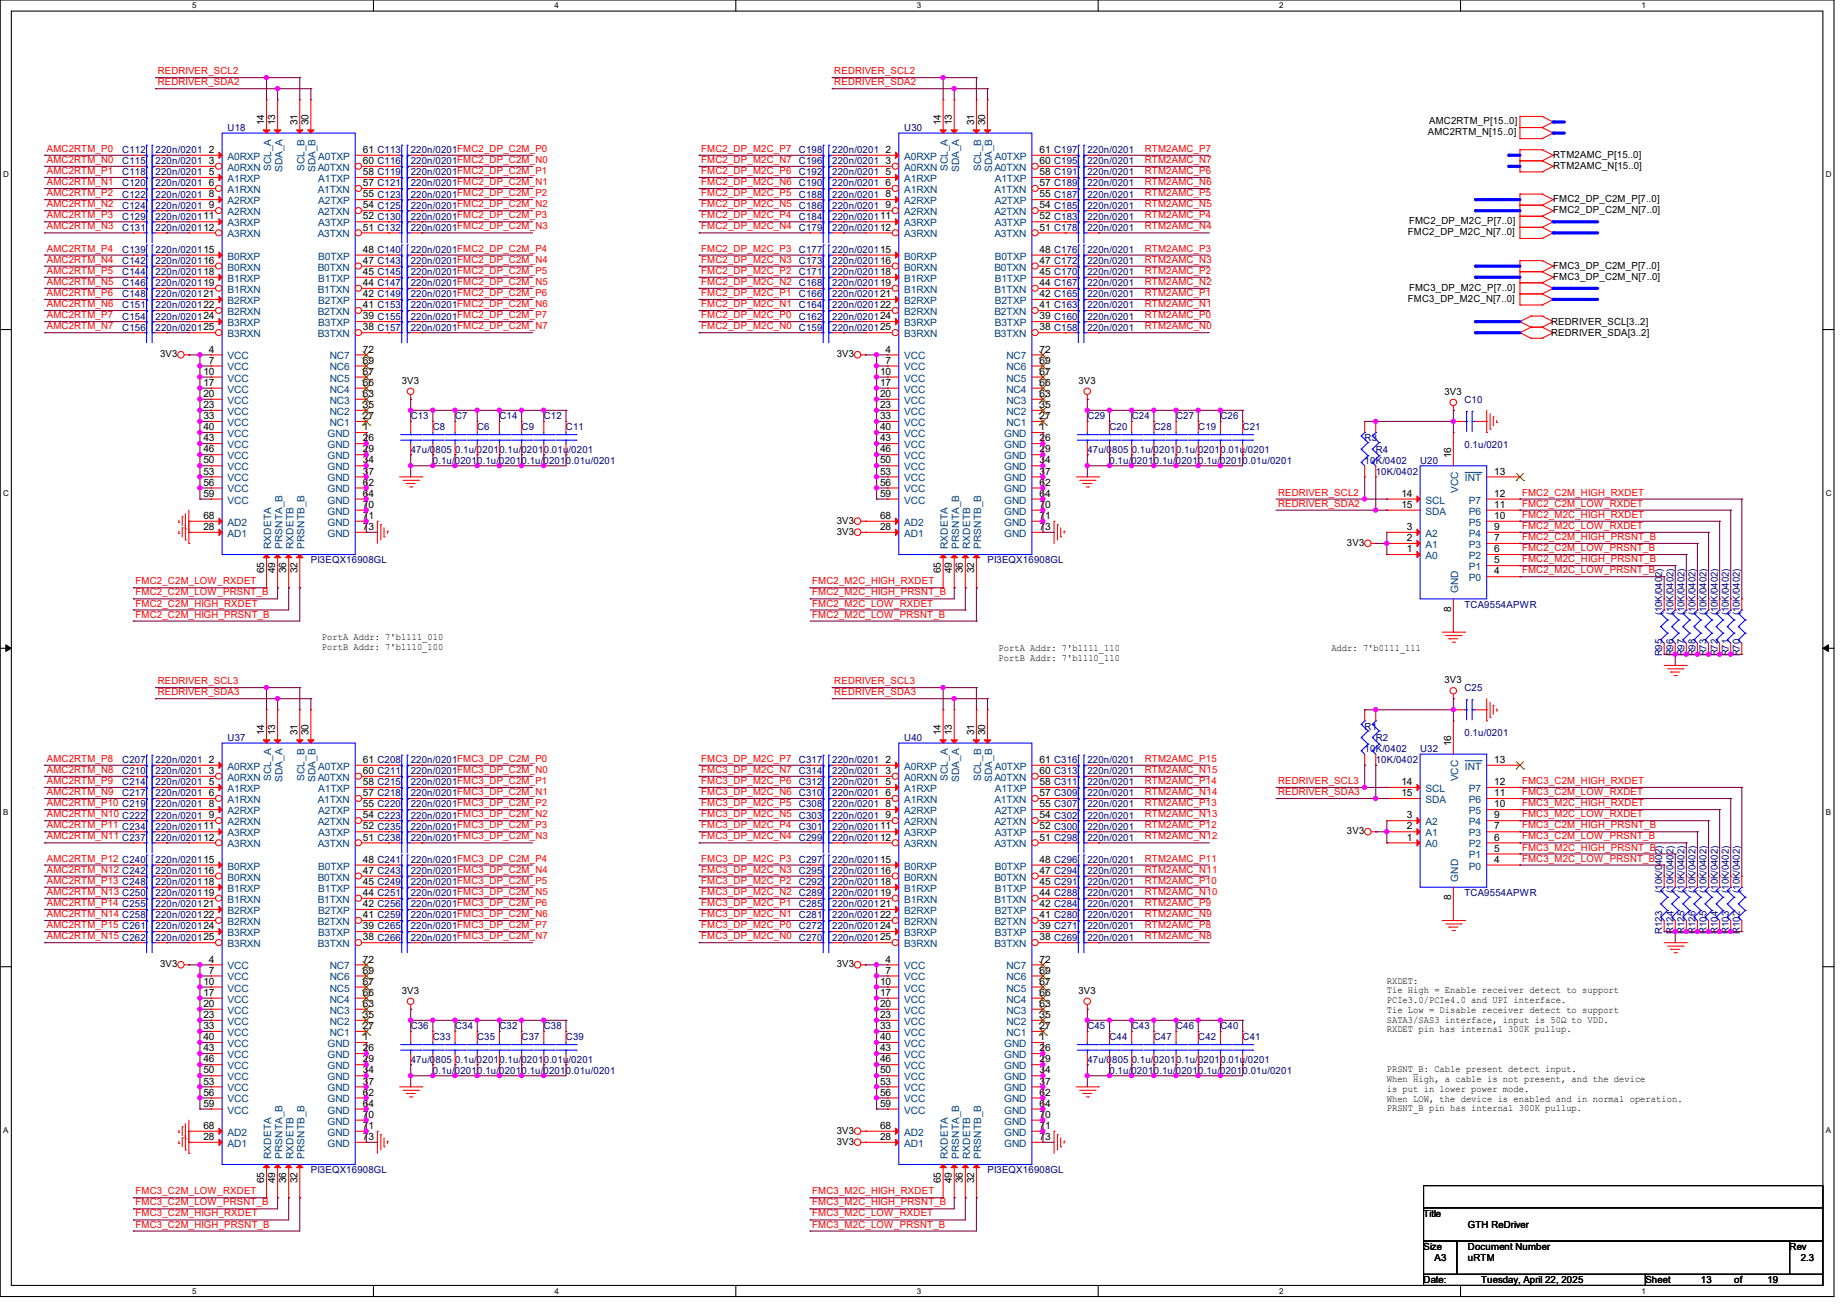
[picture p31: page 10]

RXDET:
Tie High = Enable receiver detect to support
PCIe3.0/PCIe4.0 and UPI interface.
Tie Low = Disable receiver detect to support
SATA3/SAS3 interface, input is 50Ω to VDD.
RXDET pin has internal 300K pullup.

PRSNT_B: Cable present detect input.
When High, a cable is not present, and the device
is put in lower power mode.
When LOW, the device is enabled and in normal operation.
PRSNT_B pin has internal 300K pullup.
