palzhj/u4FCPv2/template/u4FCPv2/KUP/u4FCP_V2.1_r.pdf

# AMC

# PRSNT_M2C_L SCL SDA

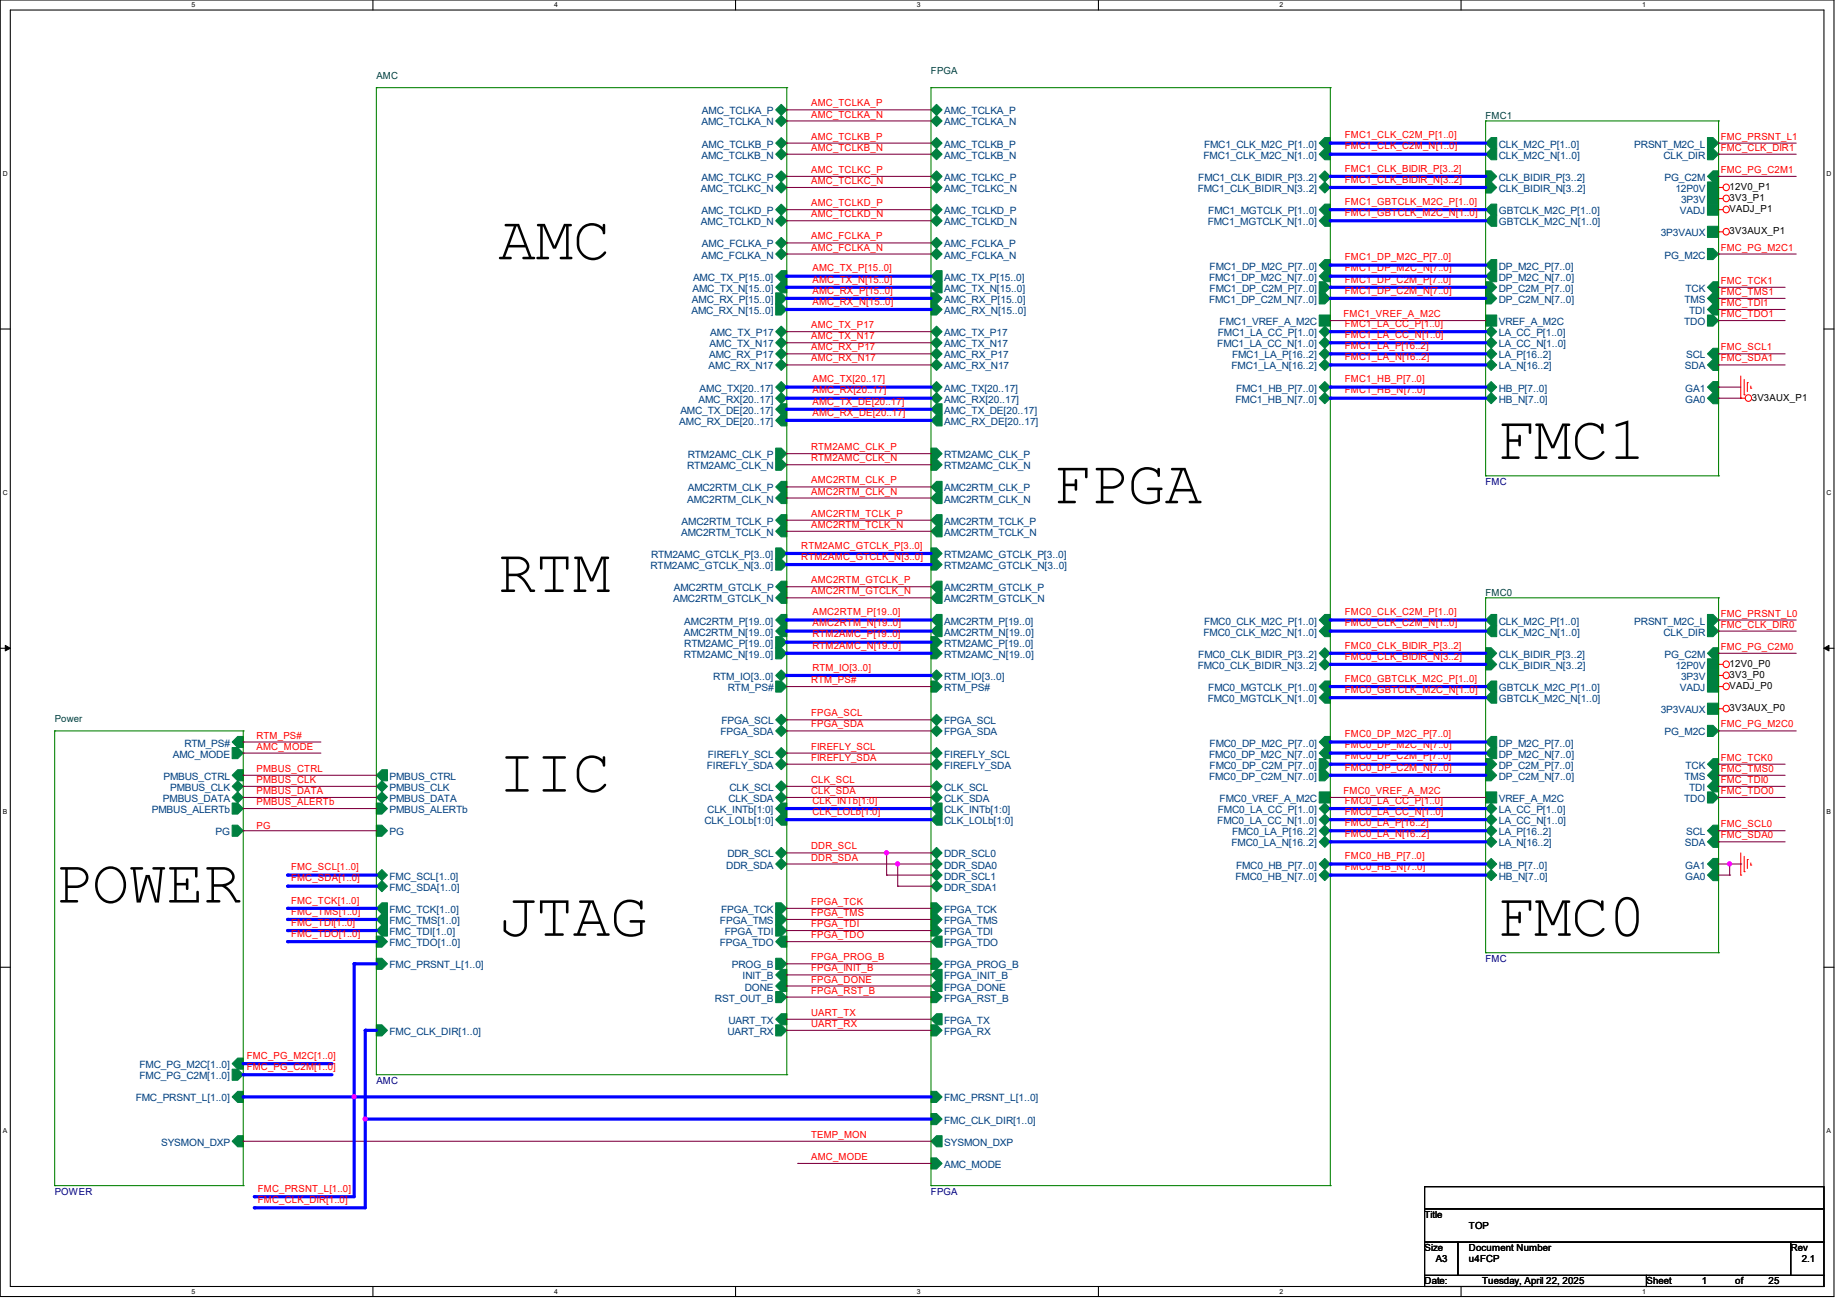
[picture p32: page 1]
FPGA; FMC1; FMC0 POWER; RTM; IIC; JTAG; VADJ_P1; VADJ_P0; 3V3AUX_P1; 3V3AUX_P0; Title Size; Document Number; Rev Date:; Sheet; of u4FCP; 2.1 TOP; Tuesday, April 22, 2025; 25 Title Size; FPGA_SCL FPGA_SDA; FMC0_VREF_A_M2C FMC0_LA_CC_N[1..0] FMC0_LA_CC_P[1..0] FMC0_LA_P[16..2] FMC0_LA_N[16..2]; FMC1_LA_P[16..2] FMC1_LA_N[16..2] FMC1_LA_CC_N[1..0] FMC1_LA_CC_P[1..0] FMC1_VREF_A_M2C; AMC_RX_N[15..0] AMC_TX_P[15..0]; FPGA_DONE; FPGA_PROG_B; AMC_TX_N[15..0]; FPGA_TDI FPGA_INIT_B; FPGA_TMS; FPGA_TCK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

# MP_3V3 MP_3V3 AMC_MP_3V3

J1GND 85 PWR 84 PS0# 83 GND 82 FCLKA- 81 FCLKA+ 80 GND 79 TCLKB- 78 TCLKB+ 77 GND 76 TCLKA- 75 TCLKA+ 74 GND 73 PWR 72 SDA_L 71 GND 70 RX7- 69 RX7+ 68 GND 67 TX7- 66 TX7+ 65 GND 64 RX6- 63 RX6+ 62 GND 61 TX6- 60 TX6+ 59 GND 58 PWR 57 SCL_L 56 GND 55 RX5- 54 RX5+ 53 GND 52 TX5- 51 TX5+ 50 GND 49 RX4- 48 RX4+ 47 GND 46 TX4- 45 TX4+ 44 GND 43 PWR 42 ENABLE# 41 GND 40 RX3- 39 RX3+ 38 GND 37 TX3- 36 TX3+ 35 GND 34 RX2- 33 RX2+ 32 GND 31 TX2- 30 TX2+ 29 GND 28 PWR 27 GA2 26 GND 25 RX1- 24 RX1+ 23 GND 22 TX1- 21 TX1+ 20 GND 19 PWR 18 GA1 17 GND 16 RX0- 15 RX0+ 14 GND 13 TX0- 12 TX0+ 11 GND 10 PWR 9 RSRVD8 8 GND 7 RSRVD6 6 GA0 5 MP 4 PS1# 3 PWR 2 GND 1

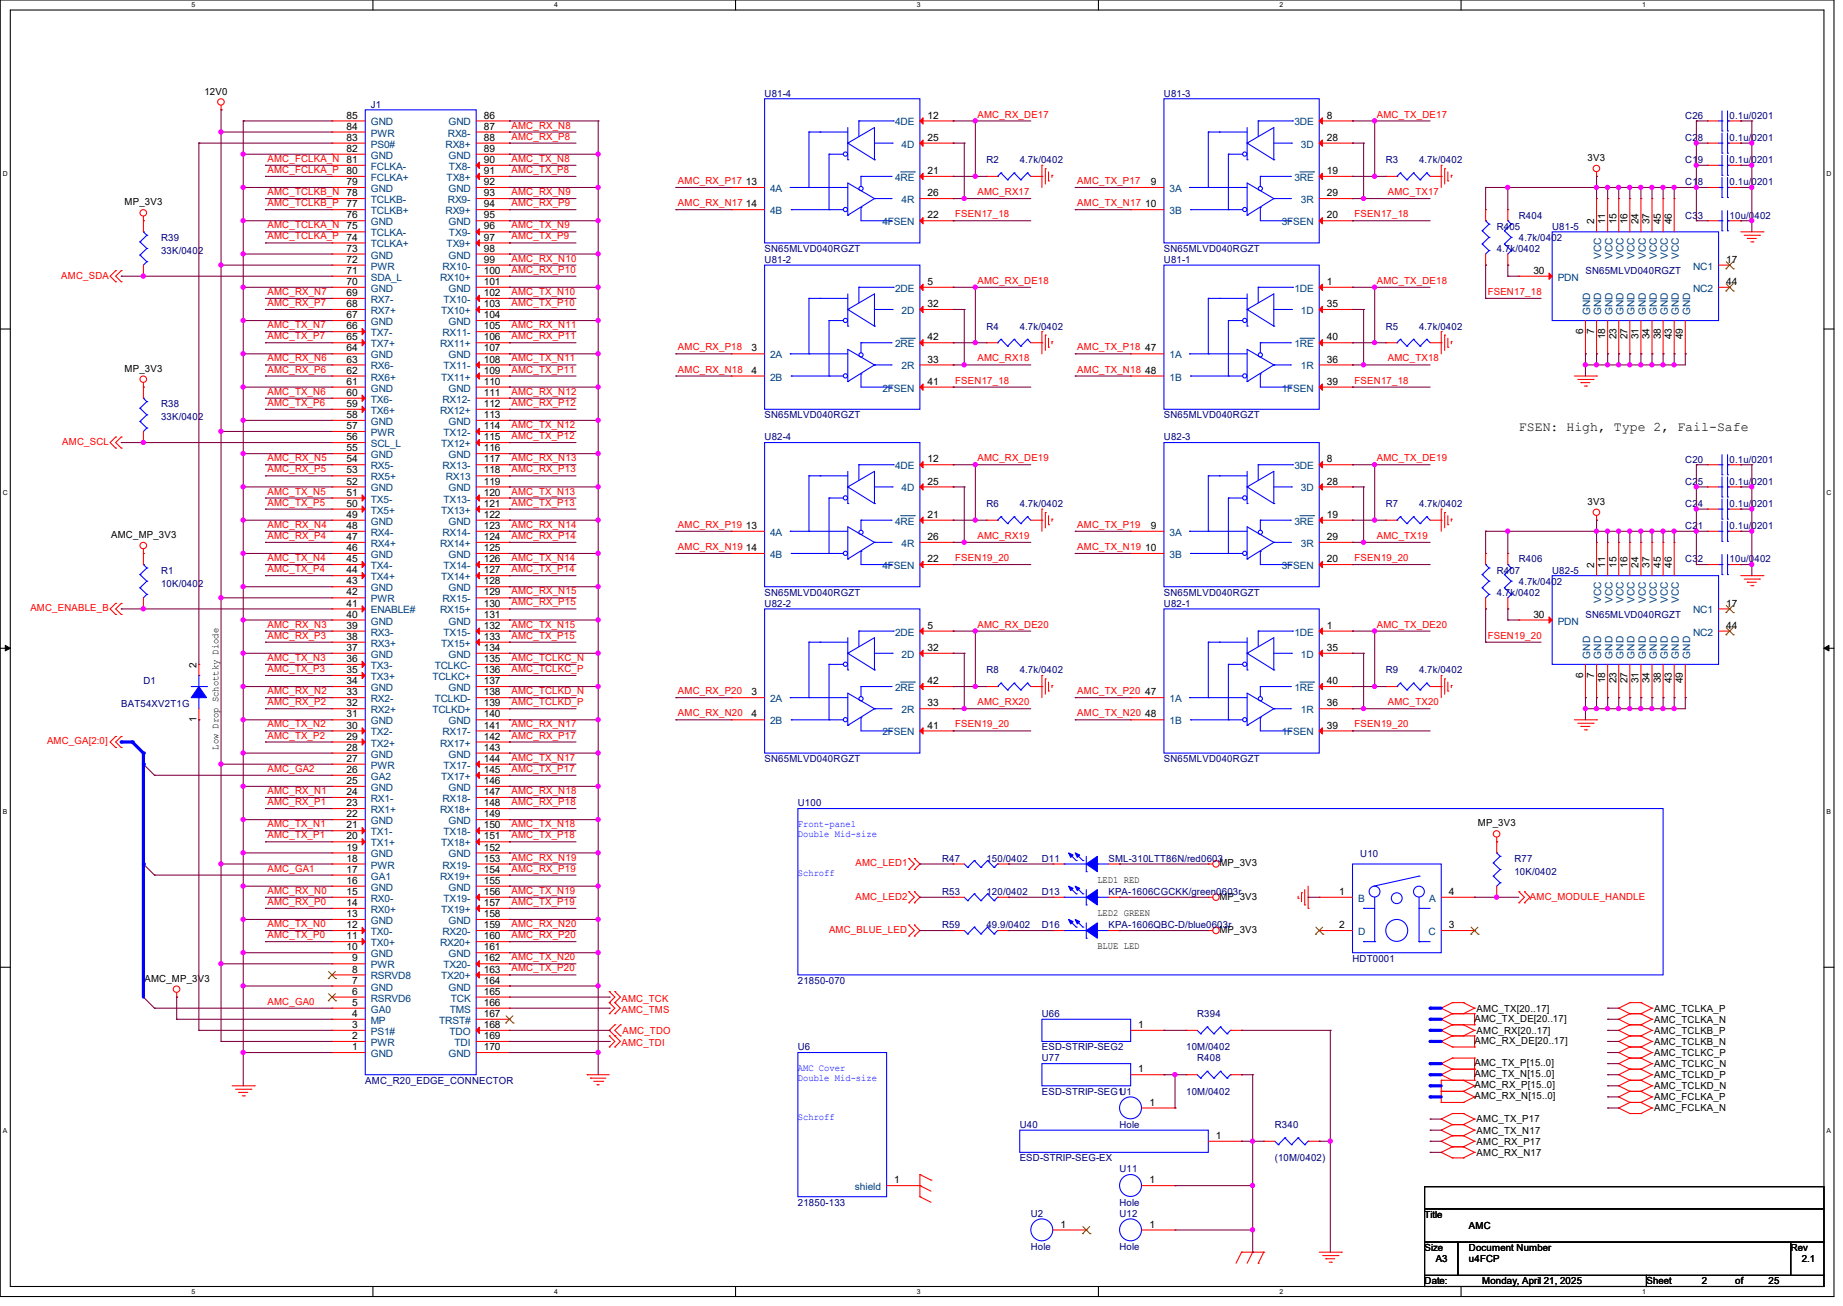
[picture p33: page 2]

GND 86 RX8- 87 RX8+ 88 GND 89 TX8- 90 TX8+ 91 GND 92 RX9- 93 RX9+ 94 GND 95 TX9- 96 TX9+ 97 GND 98 RX10- 99 RX10+ 100 GND 101 TX10- 102 TX10+ 103 GND 104 RX11- 105 RX11+ 106 GND 107 TX11- 108 TX11+ 109 GND 110 RX12- 111 RX12+ 112 GND 113 TX12- 114 TX12+ 115 GND 116 RX13- 117 RX13 118 GND 119 TX13- 120 TX13+ 121 GND 122 RX14- 123 RX14+ 124 GND 125 TX14- 126 TX14+ 127 GND 128 RX15- 129 RX15+ 130 GND 131 TX15- 132 TX15+ 133 GND 134 TCLKC- 135 TCLKC+ 136 GND 137 TCLKD- 138 TCLKD+ 139 GND 140 RX17- 141 RX17+ 142 GND 143 TX17- 144 TX17+ 145 GND 146 RX18- 147 RX18+ 148 GND 149 TX18- 150 TX18+ 151 GND 152 RX19- 153 RX19+ 154 GND 155 TX19- 156 TX19+ 157 GND 158 RX20- 159 RX20+ 160 GND 161 TX20- 162 TX20+ 163 GND 164 TCK 165 TMS 166 TRST# 167 TDO 168 TDI 169 GND 170

2 VCC 11 VCC 15 VCC 16 VCC 37 VCC 45 VCC 46 VCC 24 GND 49 PDN 30 NC1 17 NC2 44
U81-5 SN65MLVD040RGZT GND

7 GND 23 GND 38 GND 27 GND 34 GND 31 GND 43 VCC

FSEN: High, Type 2, Fail-Safe

A A Low Drop Schottky Diode

U40 ESD-STRIP-SEG-EX

## Female

TE: 6469081-1

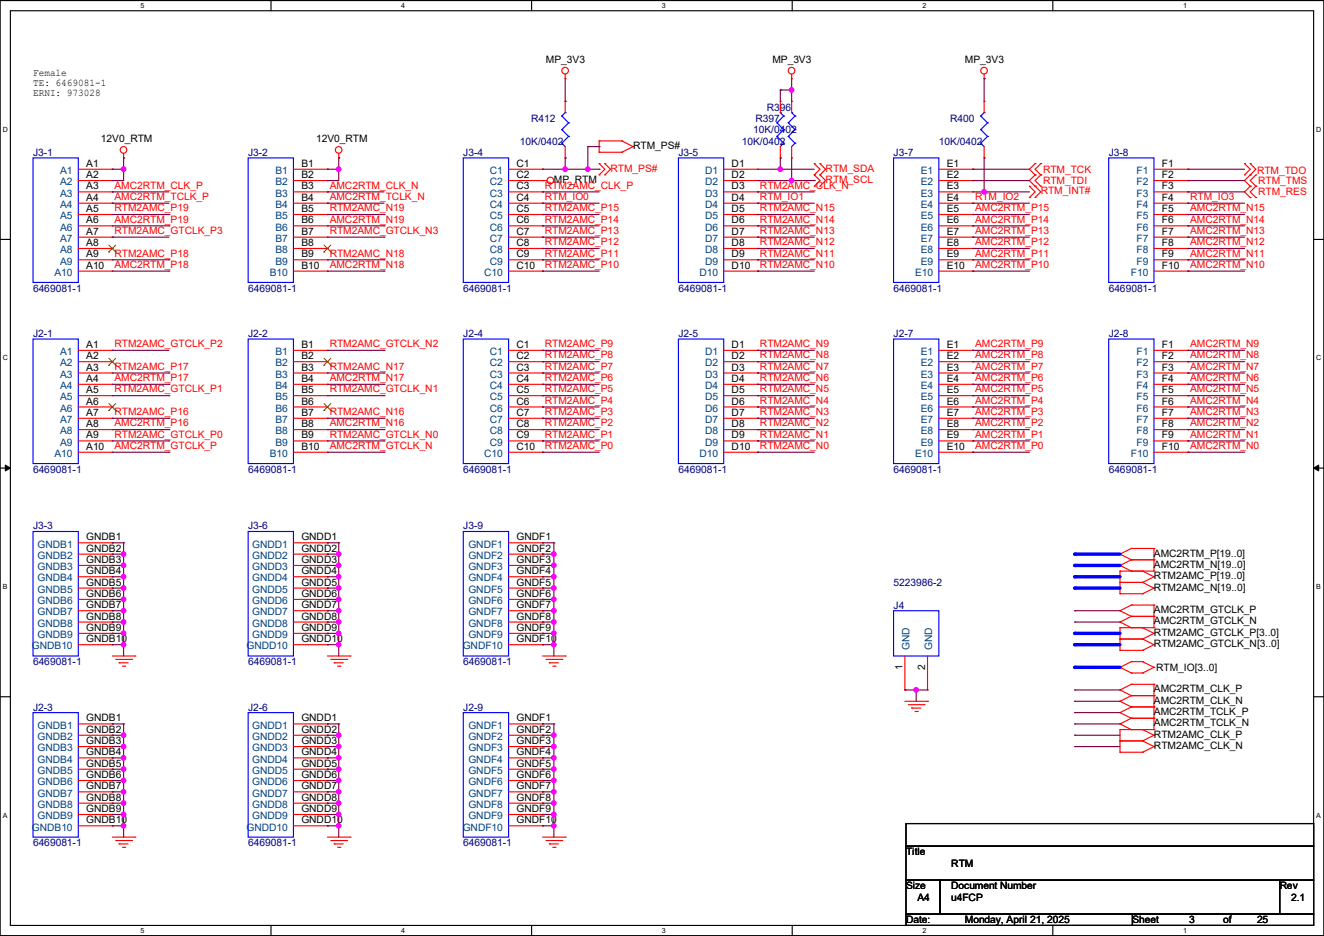
[picture p34: page 3]

# FMC2_MGTCLK227_P0 FMC2_MGTCLK227_N0 FMC2_MGTCLK226_P0 FMC2_MGTCLK226_N0

C13 | 0.1u/0201 C456 | 0.1u/0201 C458 | 0.1u/0201

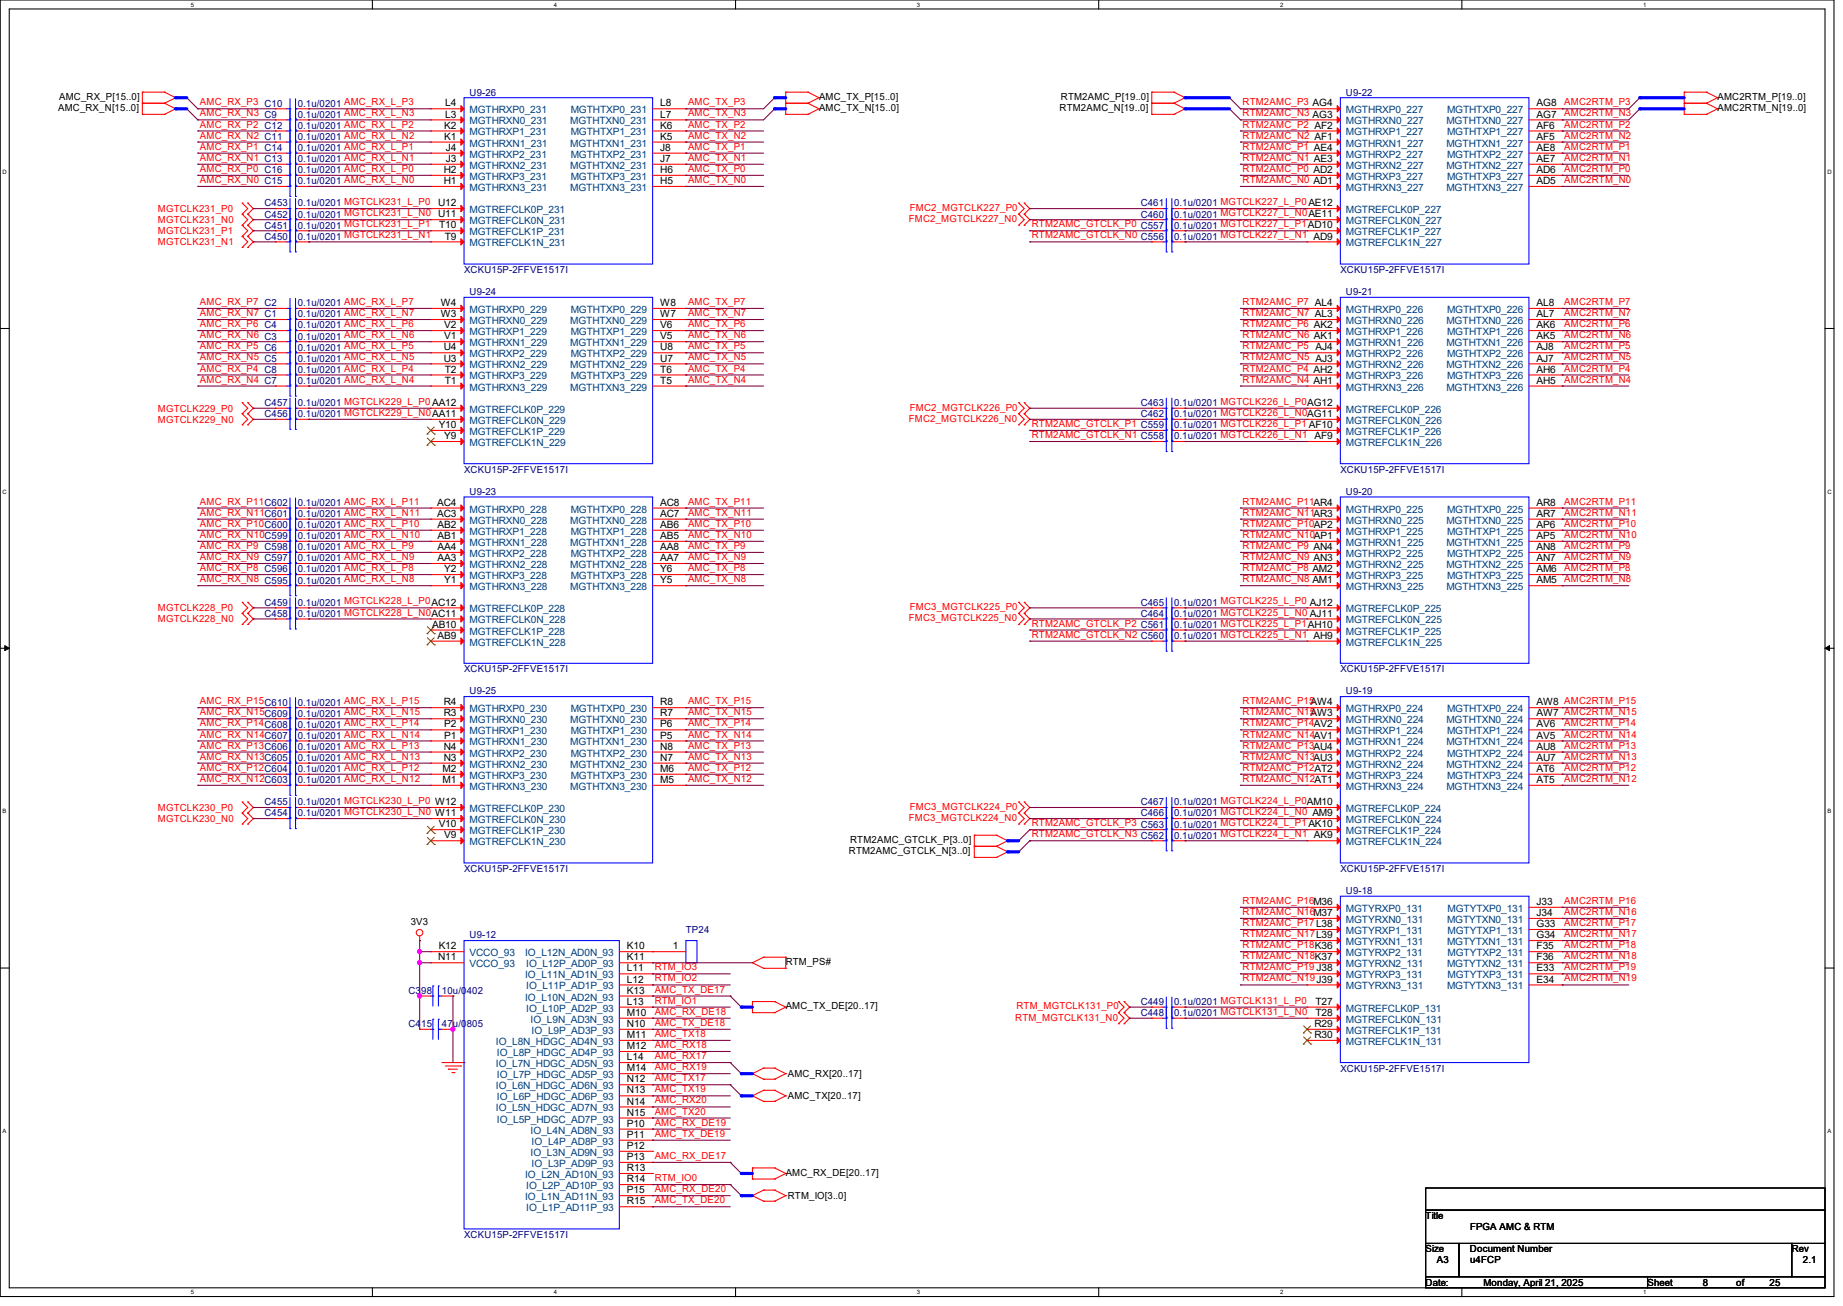
[picture p35: page 4]

OP0 27 ON0 28 OP1 30 ON1 31 OP2 33 ON2 34 OP3 36 ON3 37 OP4 39 ON4 40 OP5 42 ON5 43 OP6 45 ON6 46 OP7 48 ON7 49 OP8 77 ON8 78 OP9 80 ON9 81 OP10 83 ON10 84 OP11 86 ON11 87 OP12 89 ON12 90 OP13 92 ON13 93 OP14 95 ON14 96 OP15 98 ON15 99 | C⁸⁸ ⁰.1u/0201
C554 | 0.1u/0201 C⁵⁴⁴⁰.1u/0201 | C⁴³⁴ ¹⁰u/0402

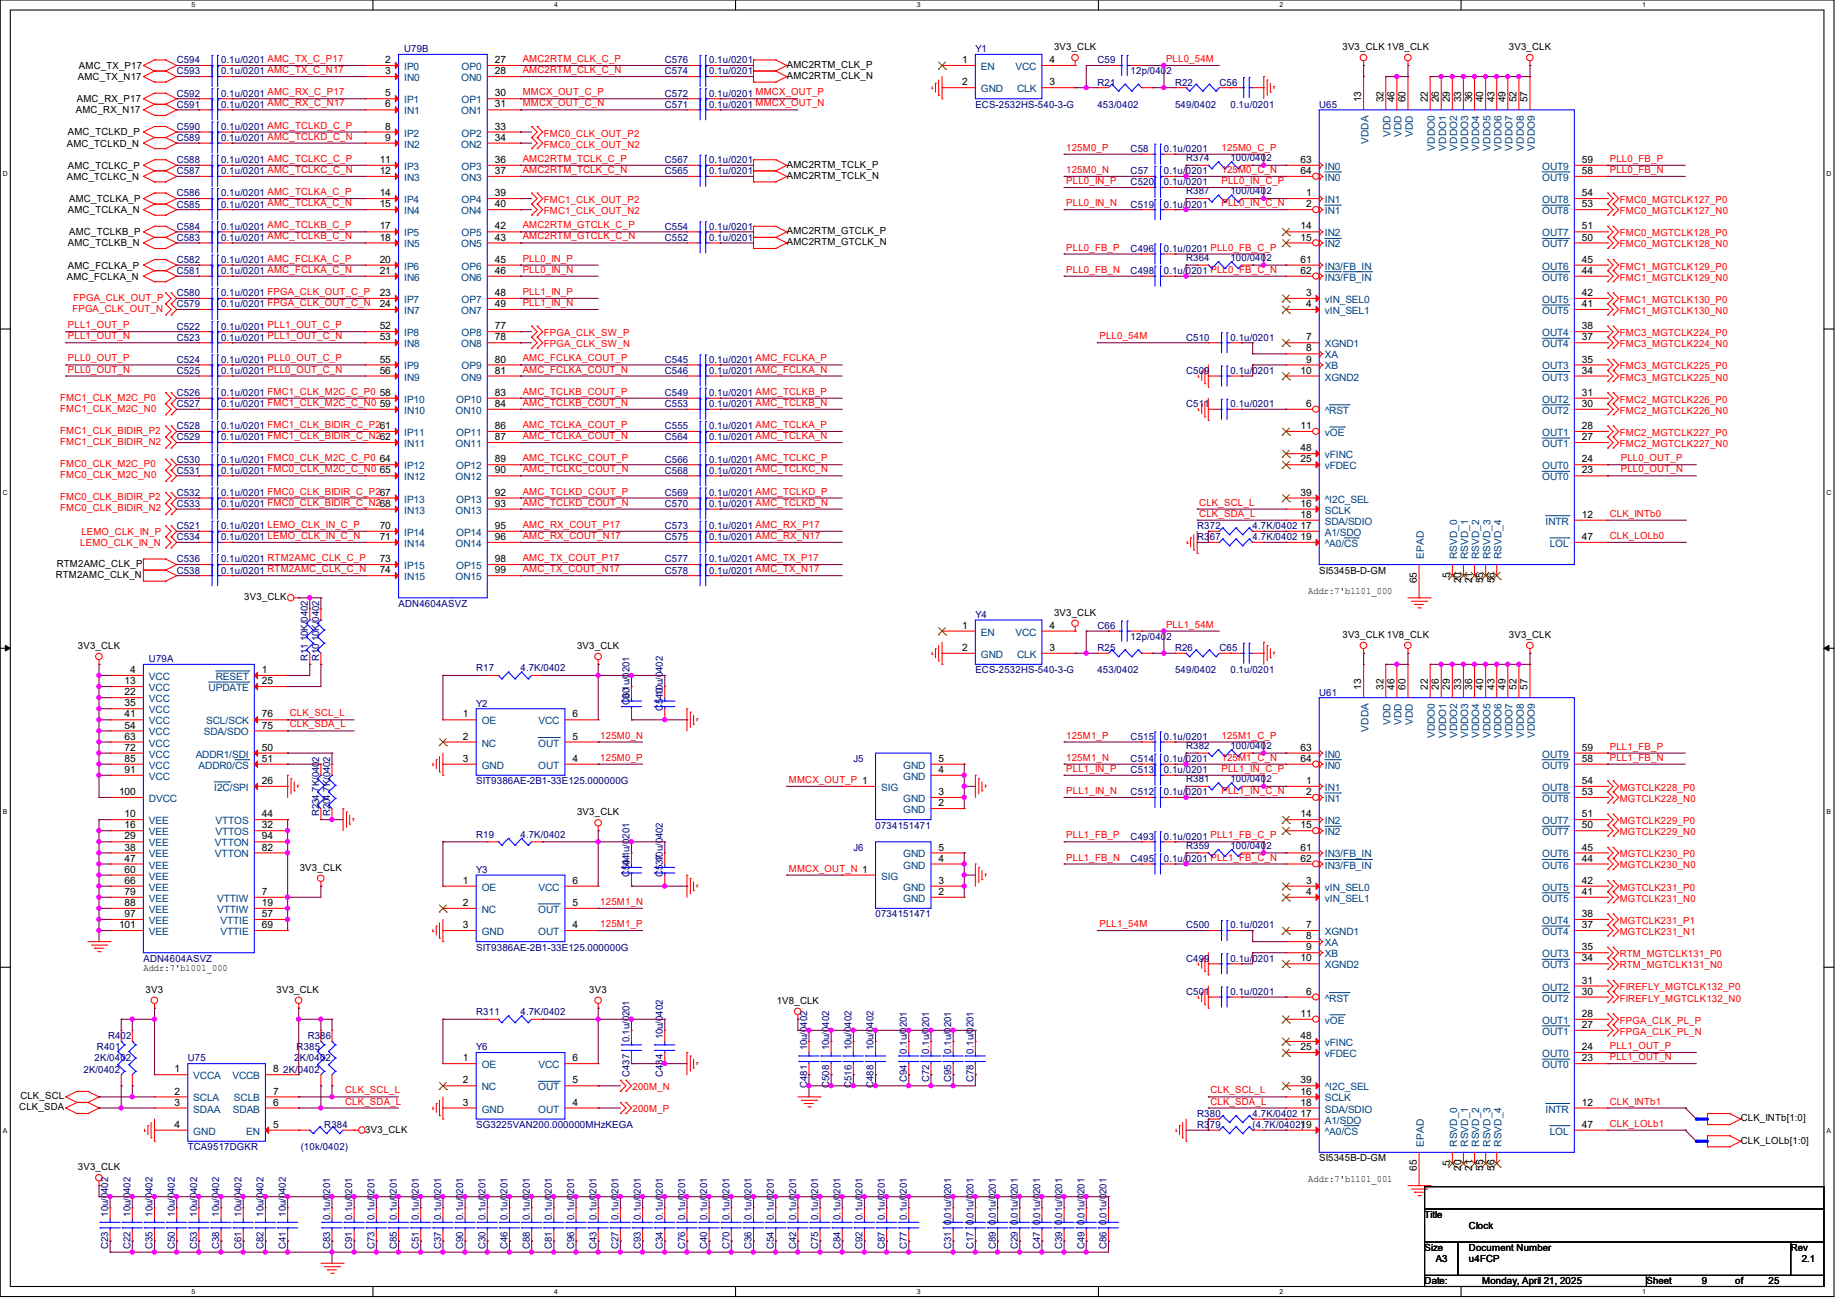
[picture p36: page 5]

IN2 15 SCLK 16 A1/SDO 17 SDA/SDIO 18

1V8

1V8

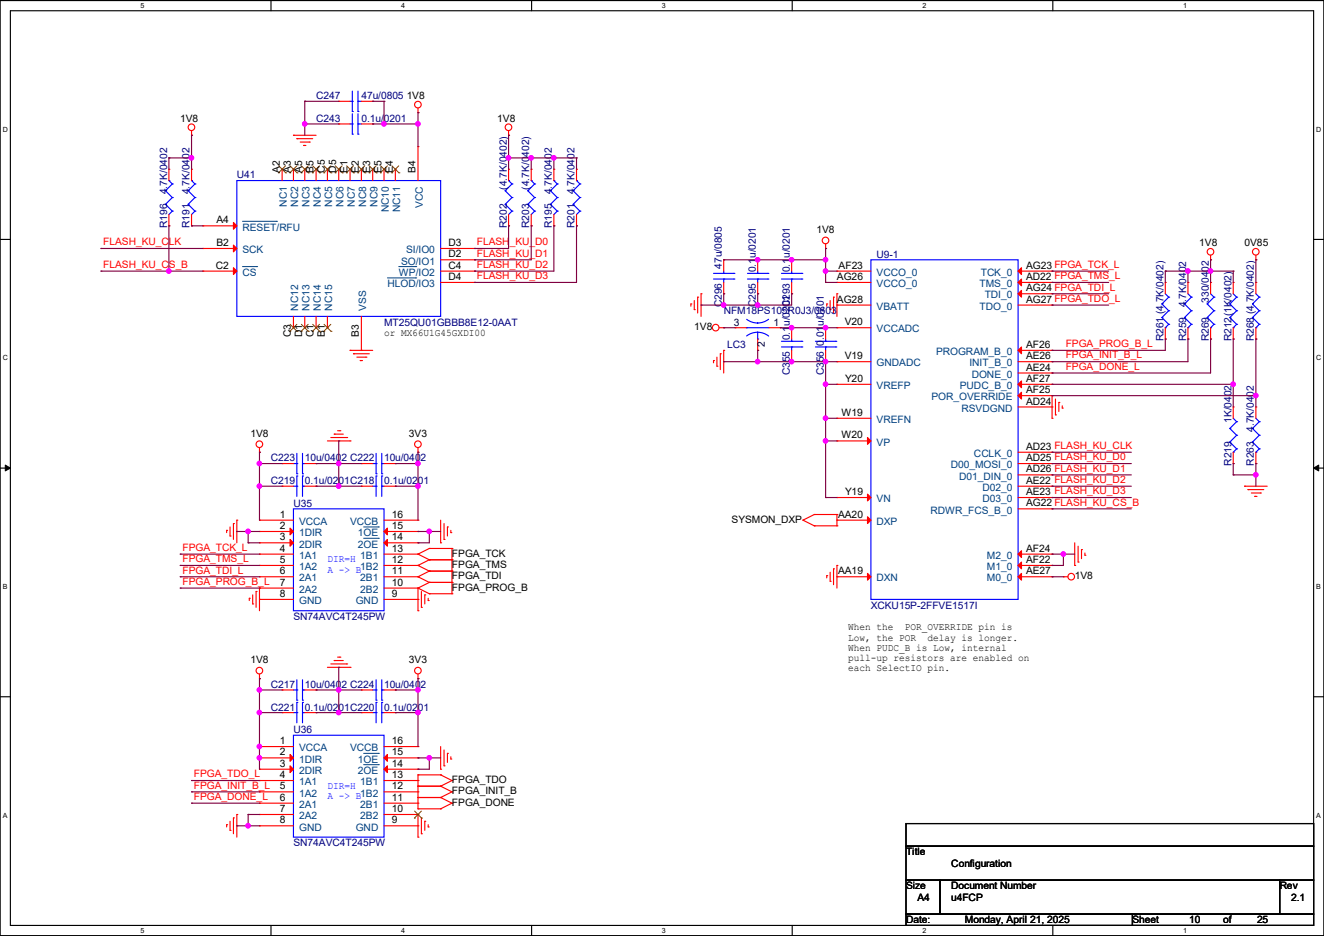
[picture p37: page 6]

WP/IO2 C4 NC⁵ C⁵ NC¹³ D¹
MT25QU01GBBB8E12-0AAT NC¹ A² NC² A³

HLOD/IO3 D4 NC⁶ D⁵ NC⁷ E¹ NC⁸ E² NC⁹ E³ NC¹⁰ E⁵ NC¹¹ E⁴

When the POR_OVERRIDE pin is
Low, the POR delay is longer.
When PUDC_B is Low, internal
pull-up resistors are enabled on
each SelectIO pin.

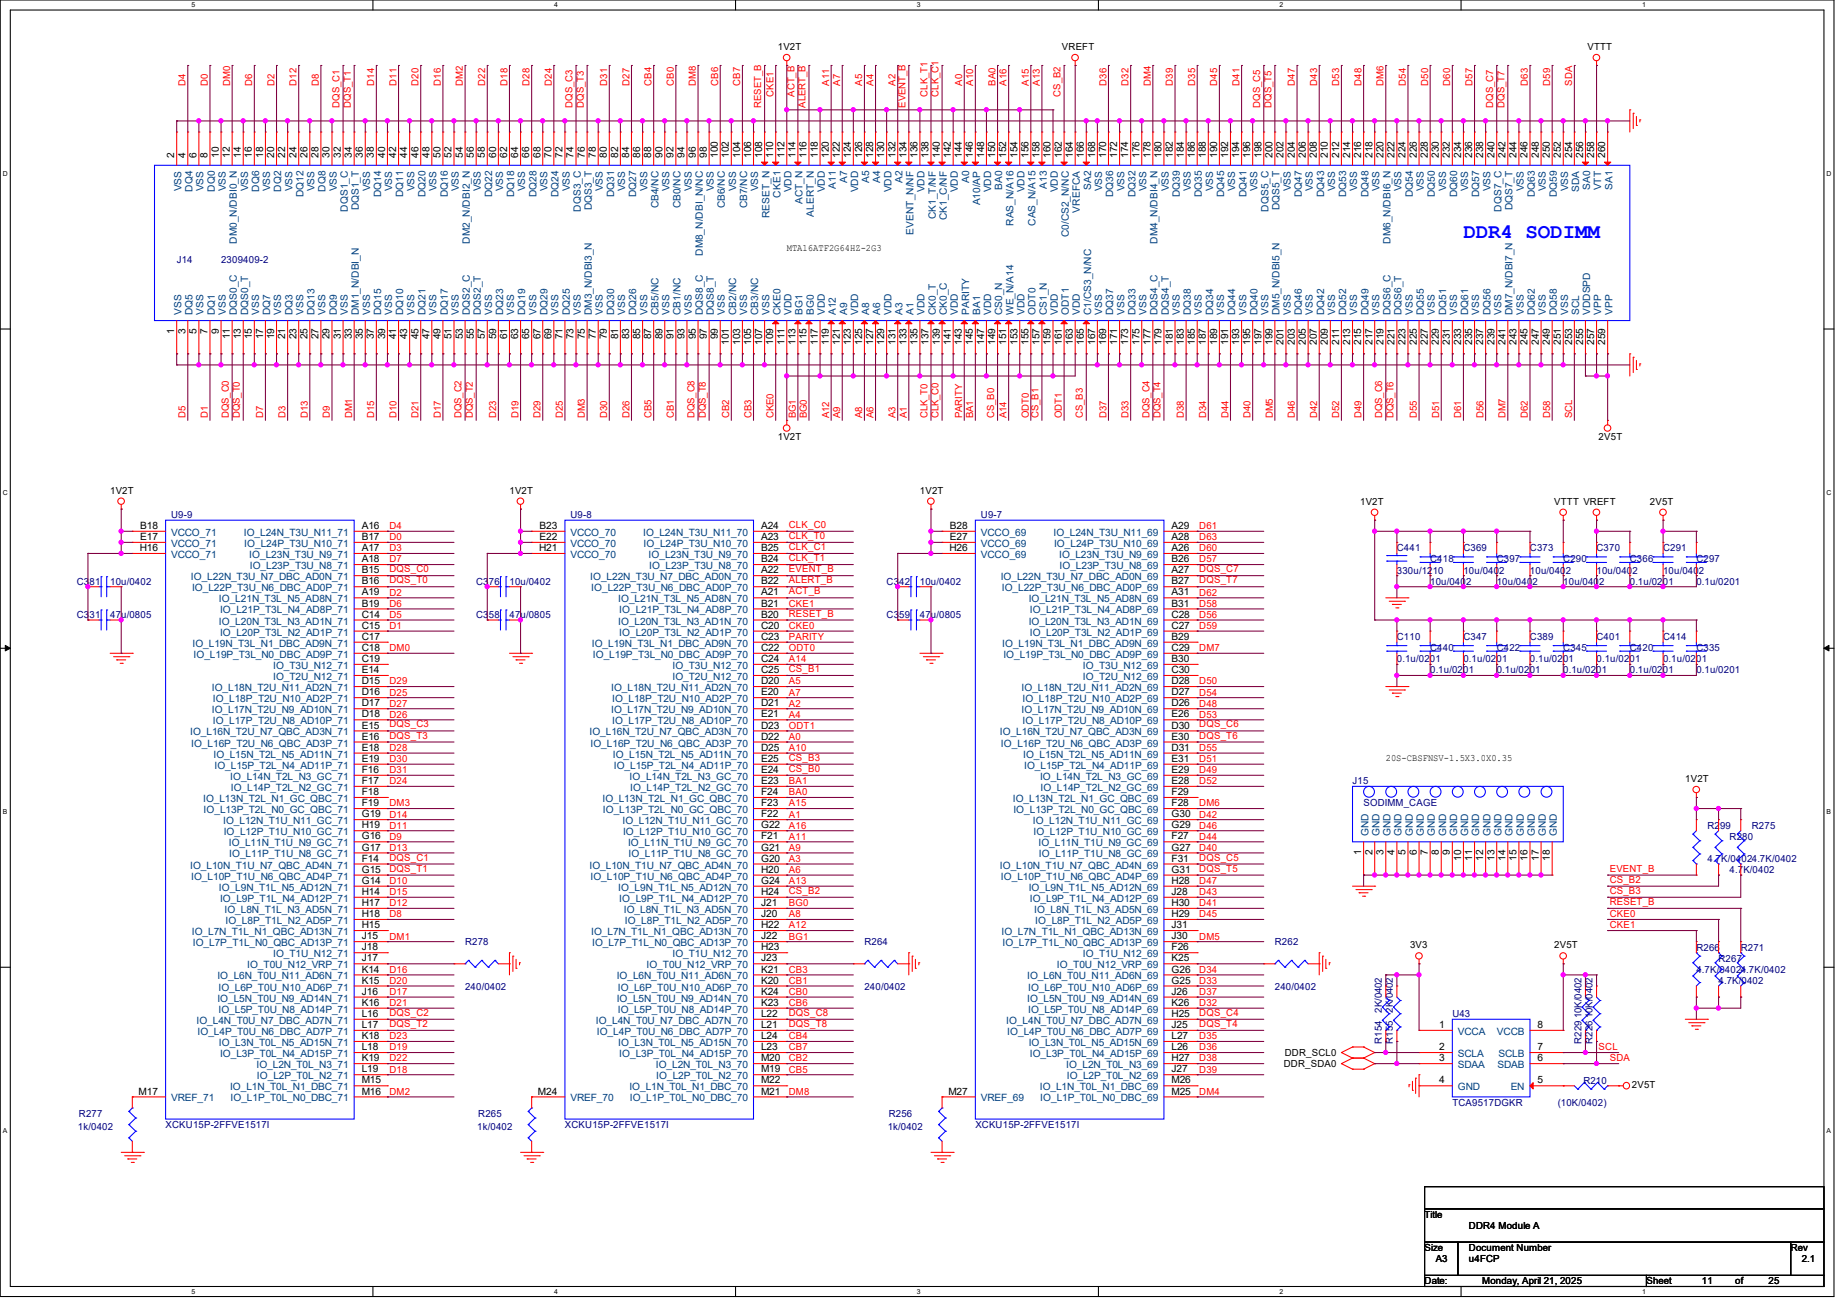
[picture p38: page 7]

8 VSS 10 DM0_N/DBI0_N 12 VSS 14 DQ6 16 VSS 18 DQ2 20 VSS 22 DQ12 24 VSS 26 DQ8 28 VSS 30 DQS1_C 32 DQS1_T 34 VSS 36 DQ14 38 VSS 40 DQ11 42 VSS 44 DQ20 46 VSS 48 DQ16 50 VSS 52 DM2_N/DBI2_N 54 VSS 56 DQ22 58 VSS 60 DQ18 62 VSS 64 DQ28 66 VSS 68 DQ24 70 VSS 72 DQS3_C 74 DQS3_T 76 VSS 78 DQ31 80 VSS 82 DQ27 84 VSS 86 CB4/NC 88 VSS 90 CB0/NC 92 VSS 94 DM8_N/DBI_N/NC 96 VSS 98 CB6/NC 100 VSS 102 CB7/NC 104 VSS 106 RESET_N 108 CKE1 110 VDD 112 ACT_N 114 ALERT_N 116 VDD 118 A11 120 A7 122 VDD 124 A5 126 A4 128 VDD 130 A2 132 EVENT_N/NF 134 VDD 136 CK1_T/NF 138 CK1_C/NF 140 VDD 142 A0 144 A10/AP 146 VDD 148 BA0 150 RAS_N/A16 152 VDD 154 CAS_N/A15 156 A13 158 VDD 160 C0/CS2_N/NC 162 VREFCA 164 SA2 166 VSS 168 DQ36 170 VSS 172 DQ32 174 VSS 176 DM4_N/DBI4_N 178 VSS 180 DQ39 182 VSS 184 DQ35 186 VSS 188 DQ45 190 VSS 192 DQ41 194 VSS 196 DQS5_C 198 DQS5_T 200 VSS 202 DQ47 204 VSS 206 DQ43 208 VSS 210 DQ53 212 VSS 214 DQ48 216 VSS 218 DM6_N/DBI6_N 220 VSS 222 DQ54 224 VSS 226 DQ50 228 VSS 230 DQ60 232 VSS 234 DQ57 236 VSS 238 DQS7_C 240 DQS7_T 242 VSS 244 DQ63 246 VSS 248 DQ59 250 VSS 252 SDA 254 SA0 256 VTT 258 SA1 260 VSS

9 DQS0_C 11 DQS0_T 13 VSS 15 DQ7 17 VSS 19 DQ3 21 VSS 23 DQ13 25 VSS 27 DQ9 29 VSS 31 DM1_N/DBI_N 33 VSS 35 DQ15 37 VSS 39 DQ10 41 VSS 43 DQ21 45 VSS 47 DQ17 49 VSS 51 DQS2_C 53 DQS2_T 55 VSS 57 DQ23 59 VSS 61 DQ19 63 VSS 65 DQ29 67 VSS 69 DQ25 71 VSS 73 DM3_N/DBI3_N 75 VSS 77 DQ30 79 VSS 81 DQ26 83 VSS 85 CB5/NC 87 VSS 89 CB1/NC 91 VSS 93 DQS8_C 95 DQS8_T 97 VSS 99 CB2/NC 101 VSS 103 CB3/NC 105 VSS 107 CKE0 109 VDD 111 BG1 113 BG0 115 VDD 117 A12 119 A9 121 VDD 123 A8 125 A6 127 VDD 129 A3 131 A1 133 VDD 135 CK0_T 137 CK0_C 139 VDD 141 PARITY 143 BA1 145 VDD 147 CS0_N 149 WE_N/A14 151 VDD 153 ODT0 155 CS1_N 157 VDD 159 ODT1 161 VDD 163 C1/CS3_N/NC 165 VSS 167 DQ37 169 VSS 171 DQ33 173 VSS 175 DQS4_C 177 DQS4_T 179 VSS 181 DQ38 183 VSS 185 DQ34 187 VSS 189 DQ44 191 VSS 193 DQ40 195 VSS 197 DM5_N/DBI5_N 199 VSS 201 DQ46 203 VSS 205 DQ42 207 VSS 209 DQ52 211 VSS 213 DQ49 215 VSS 217 DQS6_C 219 DQS6_T 221 VSS 223 DQ55 225 VSS 227 DQ51 229 VSS 231 DQ61 233 VSS 235 DQ56 237 VSS 239 DM7_N/DBI7_N 241 VSS 243 DQ62 245 VSS 247 DQ58 249 VSS 251 SCL 253 VDDSPD 255 VPP 257 VPP 259 C370

9 GND 10 GND 11 GND 12 GND 13 GND 14 GND 15 GND 16 GND 17 GND 18 R267

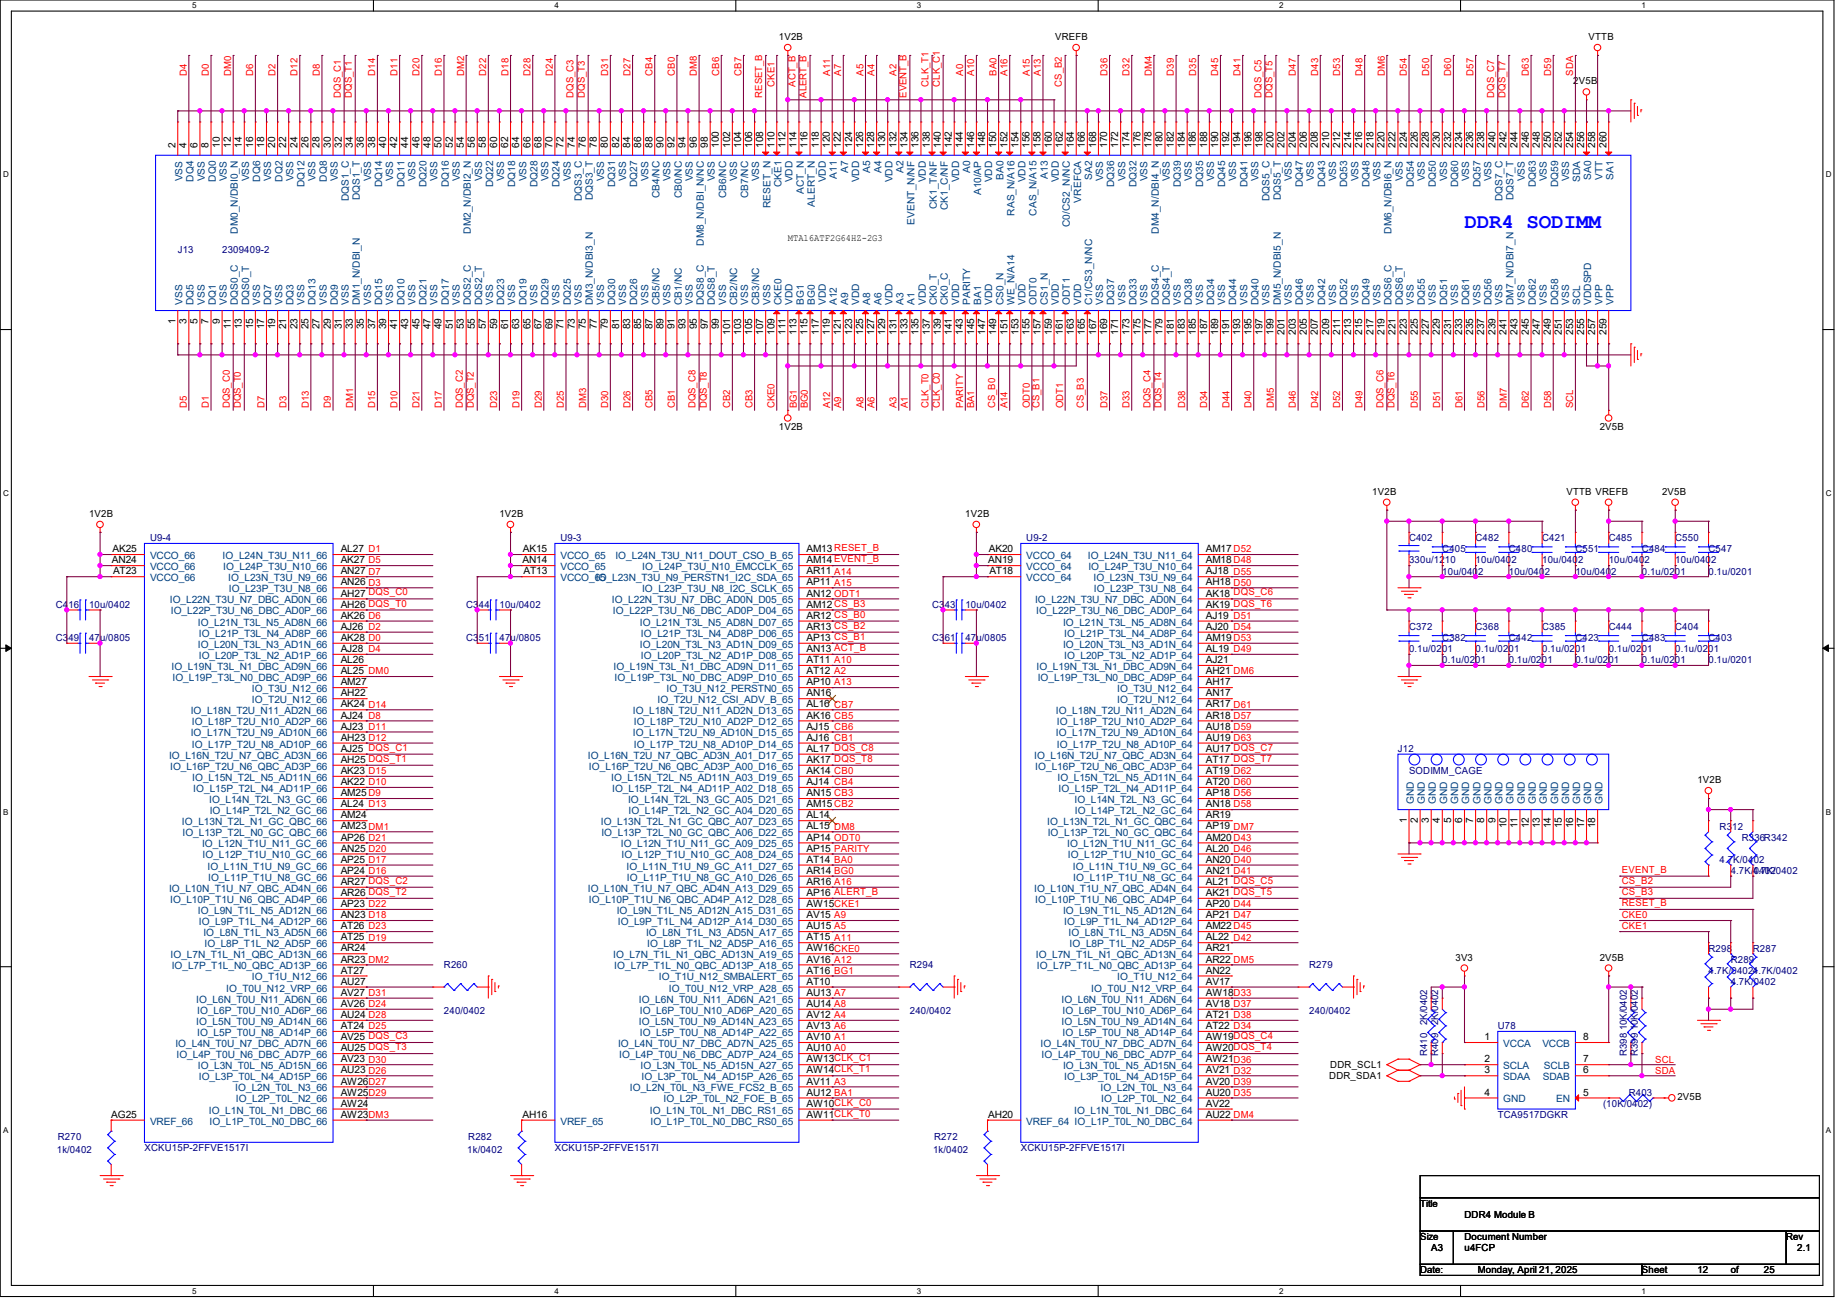
[picture p39: page 8]
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

9 GND 10 GND 11 GND 12 GND 13 GND 14 GND 15 GND 16 GND 17 GND 18 C484
0.1u/0201 U78 TCA9517DGKR

# FMC1_MGTCLK130_P0 FMC1_MGTCLK130_N0 FMC1_MGTCLK129_P0 FMC1_MGTCLK129_N0

0.1u/0201 R²¹³ ¹K/0402 C469 | 0.1u/0201 | XCKU15P-2FFVE1517I U9-17 MGTREFCLK0N_130 V28 MGTREFCLK0P_130 V27 MGTREFCLK1N_130 U30 MGTREFCLK1P_130 U29 MGTYRXN0_130 T37 MGTYRXN1_130 R39 MGTYRXN2_130 P37 MGTYRXN3_130 N39 MGTYRXP0_130 T36 MGTYRXP1_130 R38 MGTYRXP2_130 P36 MGTYRXP3_130 N38 | MGTYTXN0_130 P32 MGTYTXN1_130 N34 MGTYTXN2_130 M32 MGTYTXN3_130 L34 MGTYTXP0_130 P31 MGTYTXP1_130 N33 MGTYTXP2_130 M31 MGTYTXP3_130 L33

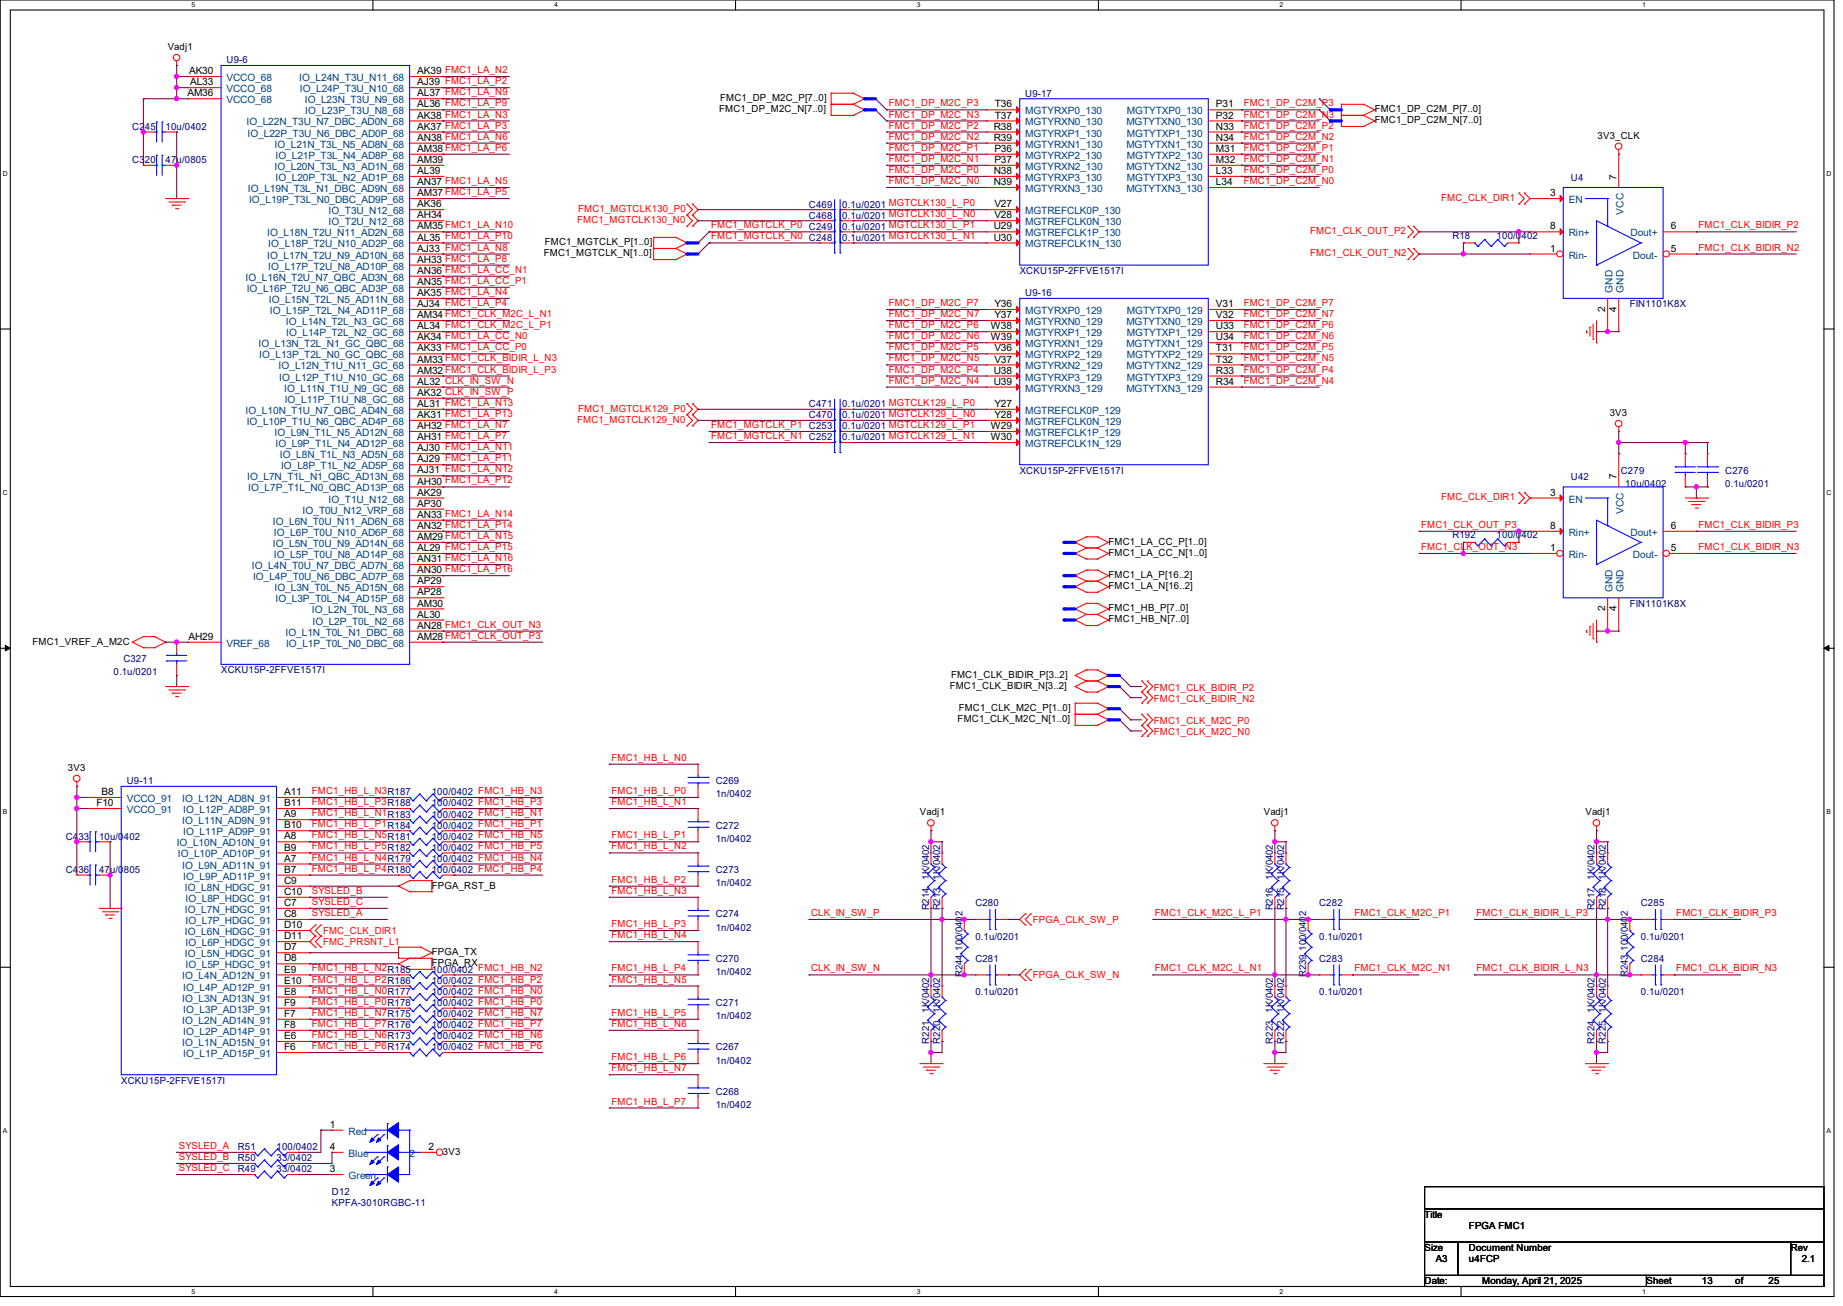
[picture p40: page 9]

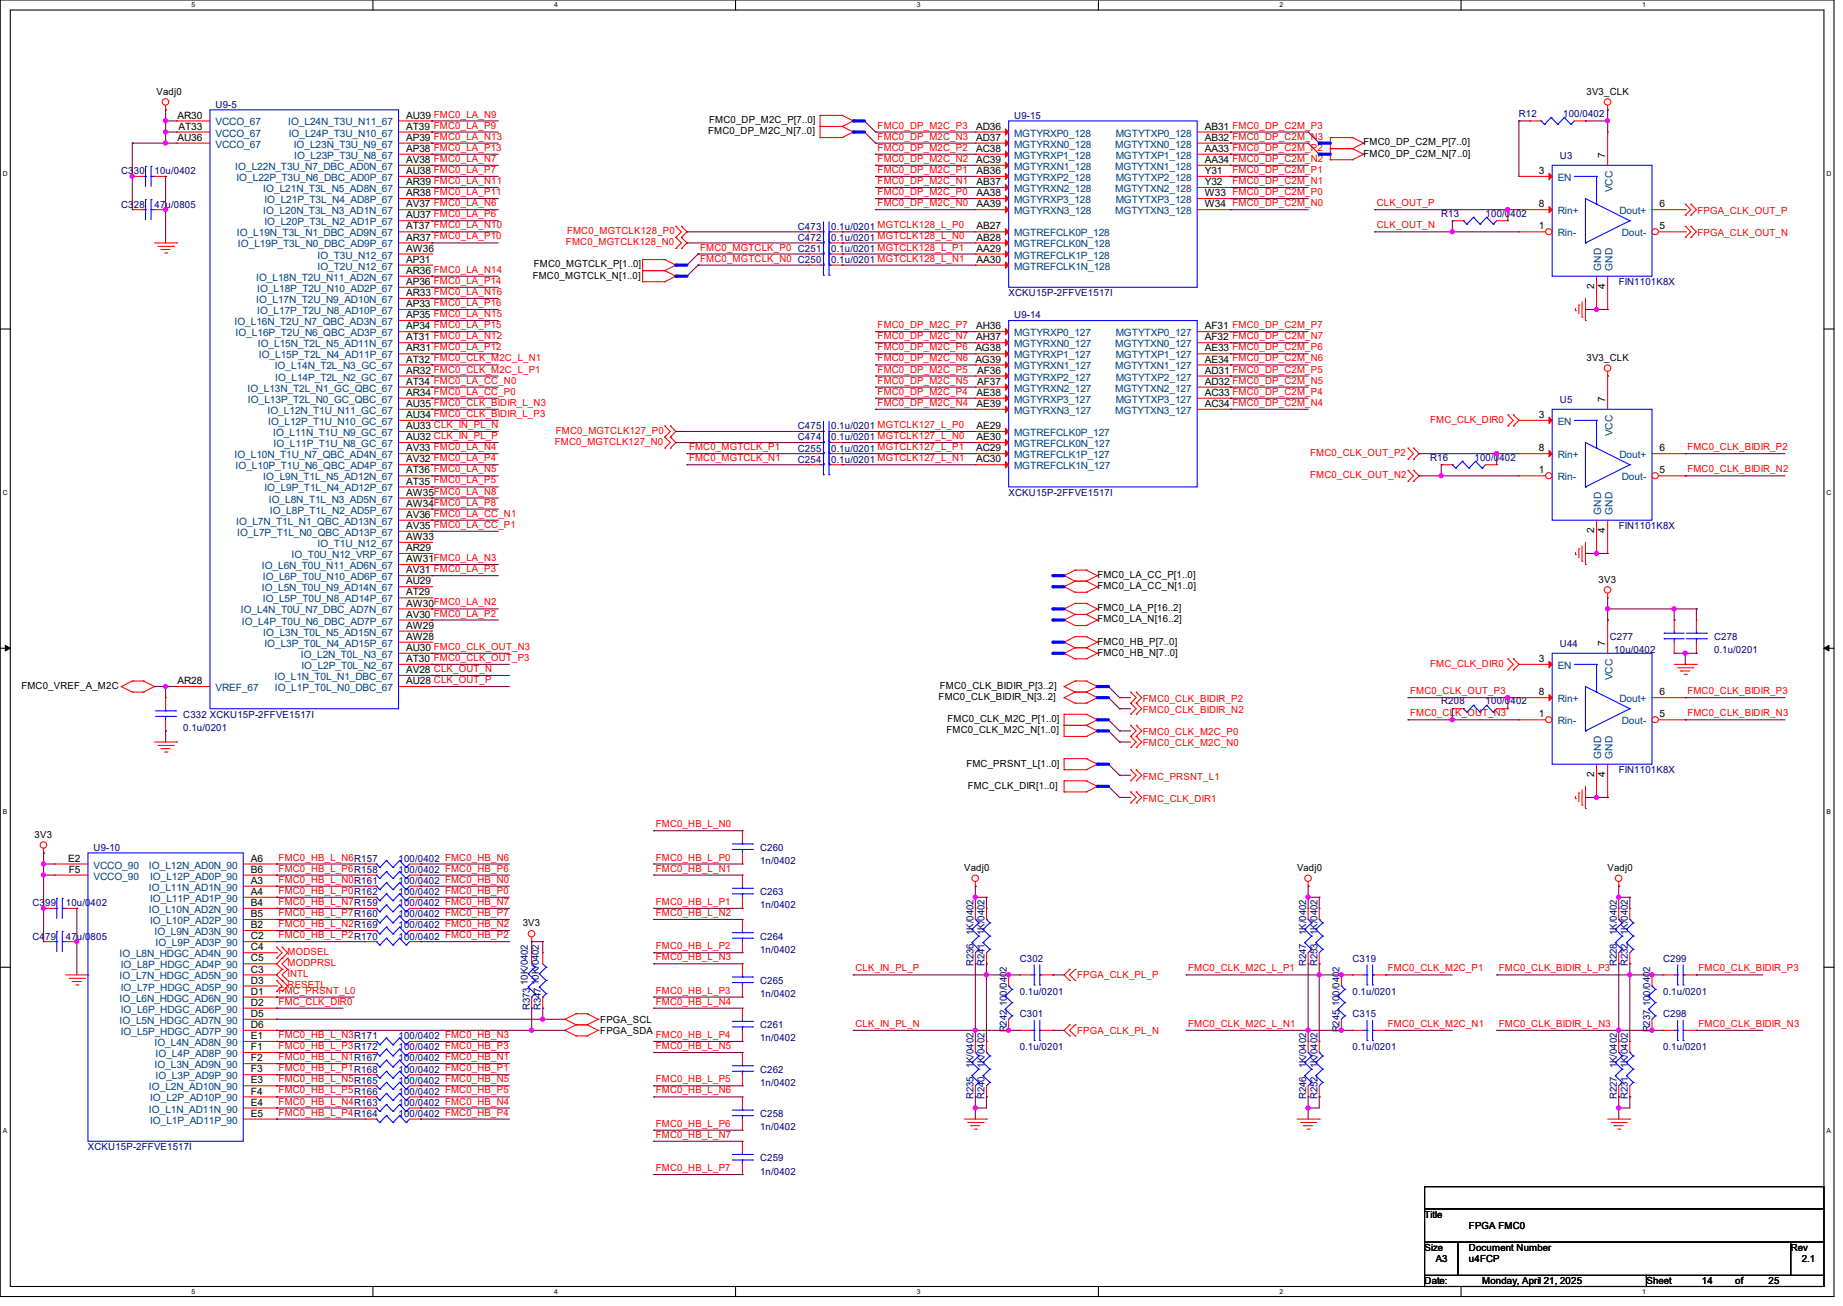
[picture p41: page 10]

## 1V8_CLK

3V3

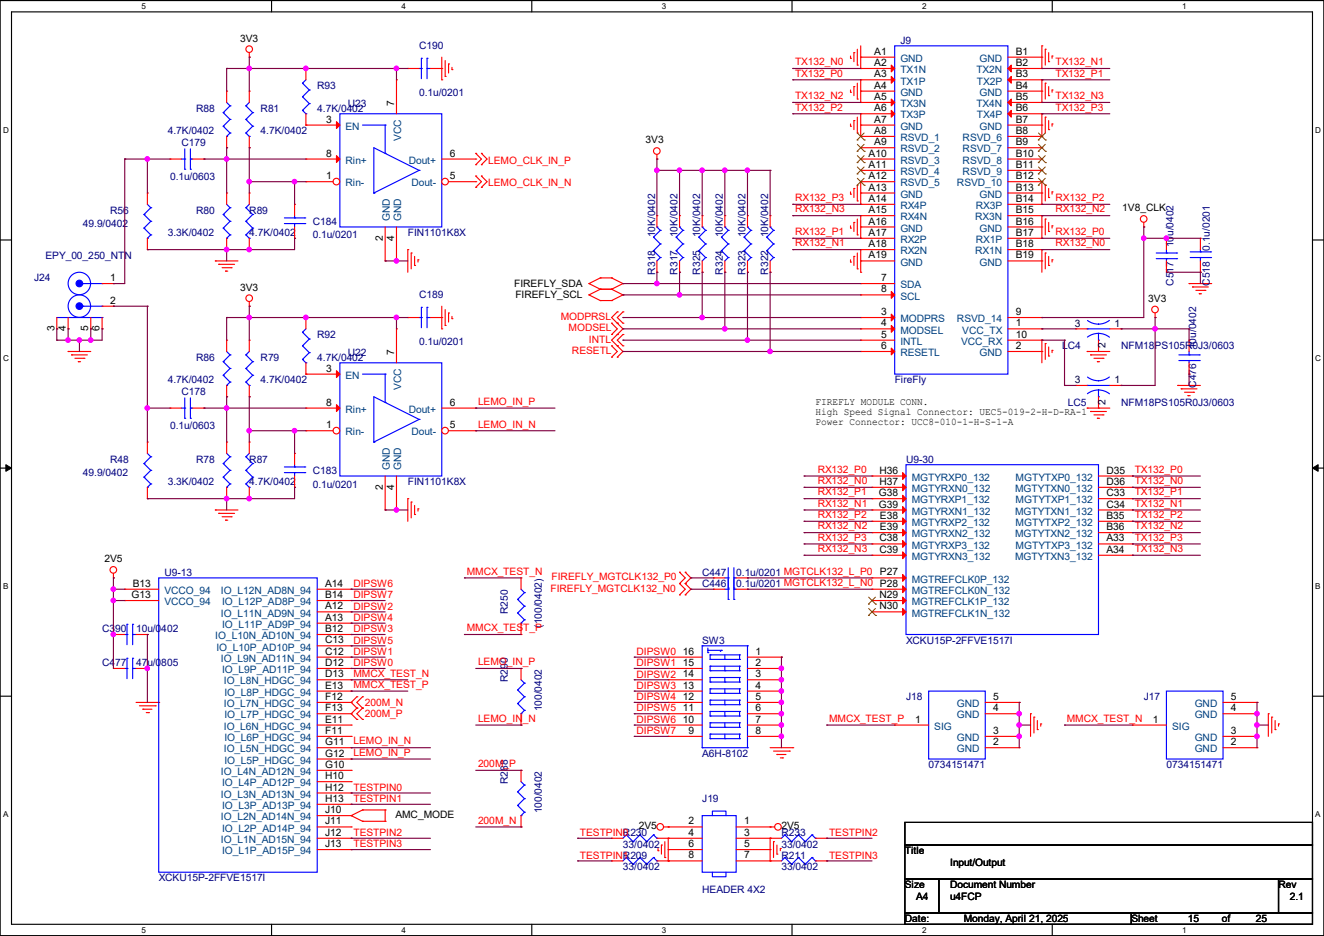
[picture p42: page 11]

FIREFLY MODULE CONN.
High Speed Signal Connector: UEC5-019-2-H-D-RA-1
