palzhj/u4FCPv2/(commit log)

2022-05-26 add I2C
2022-09-16 update led
2024-01-12 add the board outline with screw locations
2024-01-16 init sitcp project
    [reg_table.xlsx]
2024-02-03 use '--enable' switch to generate necessary files only
2024-02-04 change I2C I/O power supply from VDD(core) to VDDA(3.3)
2024-02-08 update UCD power monitor
2024-02-17 add sitcp for RTM port16
    [reg_table.xlsx]
2024-04-01 remove power control
2024-10-30 add power config
2024-10-31 add project for SiTCP
    [reg_table.xlsx]
2024-10-31 fix bug on SPI reset
    [RBCP_REG.v]
2024-11-02 update I2C
2025-02-24 add schematics
2025-03-07 update power
2025-03-26 add step files
    [U4FCP_V2_bare_pcb.stp]
2025-03-28 add 3D model for uRTM
    [URTM_V2_3D_bare_pcb.stp]
2025-04-01 add sitcp for firefly connection0
    [reg_table.xlsx]
2025-07-22 add connectivity test
    [reg_table.xlsx]
2025-08-12 add schematics for 2.1
2025-08-18 update Schematics
2025-09-10 update power controlled by MCU
2026-07-23 fix xdc bug CLK_IN_PL to 125MHz
    [u4fcpv2_top.xdc]
2026-08-08 add SiTCP_XG
    [reg_table.xlsx]
2026-09-17 add SHINE-WR support
    [reg_table.xlsx]
2026-09-21 fix bug in the reset_pulse_extender
    [RESET.v, top.v]
