palzhj/u4FCPv2/(notices)

Notices in the files:
template/u4FCPv2/KUP/sitcpxg_x4-fmc1/sources/wishbone/wb_i2c/i2c_master_top.v:
Copyright (C) 2001 Richard Herveille
